metcalf/hvac_control/zone_controller/README.md

lvgl_esp32_drivers is old and doesn't support ESP32S3, forks that look promising:

- https://github.com/VitorAlho/lvgl_esp32_drivers
- https://github.com/artemisoftnian/lvgl_esp32_drivers
- https://github.com/BunnySakura/lvgl_esp32_drivers
- https://github.com/COP-AMACO/lvgl_esp32_drivers
