metcalf/hvac_control/components/cxi_client/README.md

Ported from Go: https://github.com/gonzojive/heatpump/tree/main/fancoil
