metcalf/hvac_control/case/label_alignment.dxf

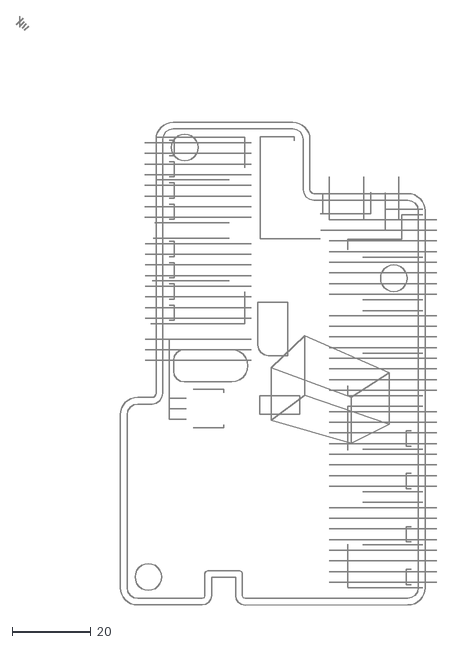
[picture p2: CAD file, 2024-07-10]
case/label_alignment.dxf
106.7 x 149.5
