metcalf/hvac_control/case/touch_panel_bracket.dxf

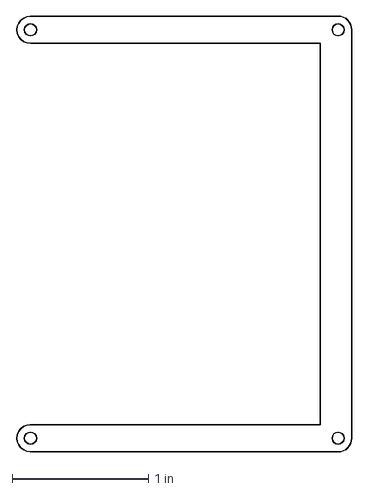
[picture p3: CAD file, 2024-07-08]
case/touch_panel_bracket.dxf
2.46 x 3.20 in
