metcalf/hvac_control/case/controller_top.stl

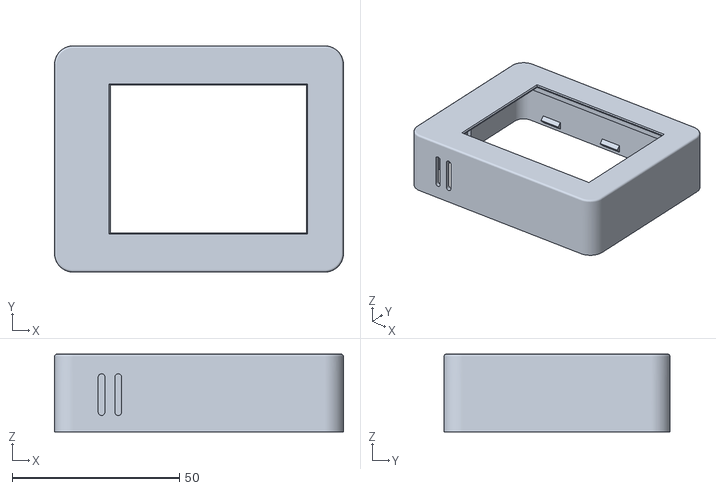
[picture p4: CAD file, 2024-06-24]
case/controller_top.stl
86.5 x 67.7 x 23.3
