metcalf/hvac_control/case/controller_bottom_v3.stl

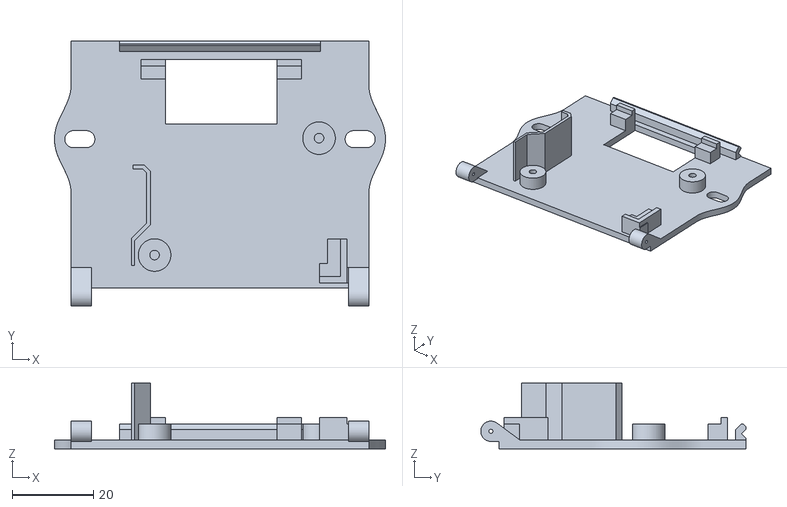
[picture p5: CAD file, 2024-06-24]
case/controller_bottom_v3.stl
81.3 x 65.2 x 16.1
