metcalf/hvac_control/case/label plate.dxf

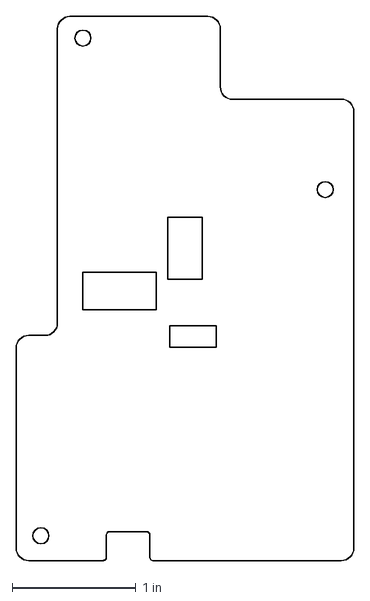
[picture p6: CAD file, 2024-06-24]
case/label plate.dxf
2.73 x 4.40 in
