metcalf/hvac_control/case/20240705-label-plate.dxf

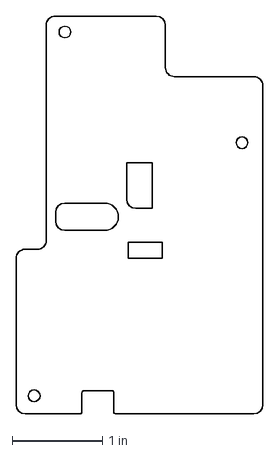
[picture p7: CAD file, 2024-07-08]
case/20240705-label-plate.dxf
2.73 x 4.40 in
