metcalf/hvac_control/(list of files, cad)

Other CAD files:
case/controller_top_v3.stl
case/controller_bottom.stl
case/controller_bottom_v2.stl
case/controller_top_v2.stl
