metcalf/hvac_control/eagle/printed/20251027-temp_board.brd

## EAGLE design eagle/printed/20251027-temp_board.brd (2025-10-27)

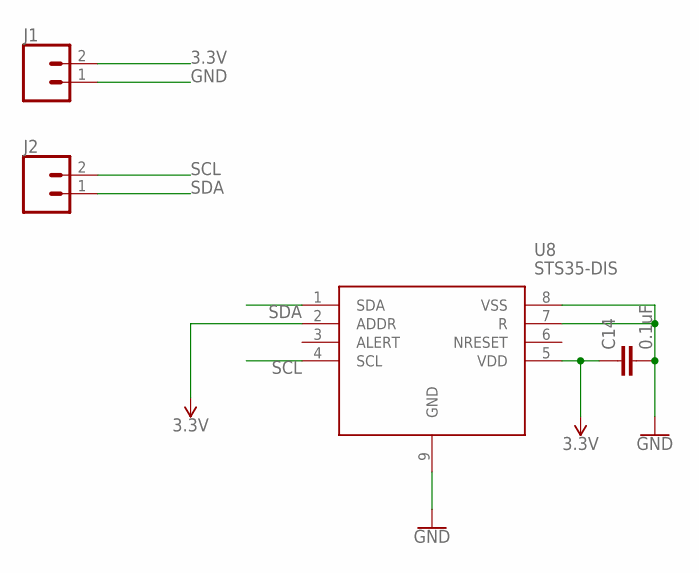
[picture p8: schematic 20251027-temp_board.sch]

Parts:
C14: 0.1uF; 0603
J1, J2: CONN_02_1.5MM; 1X02_1.5MM_NO_SILK
U8: STS35-DIS; SON50P250X250X100-9N

Connections:
3.3V: C14.1, J1.2, U8.2 (ADDR), U8.5 (VDD)
GND: C14.2, J1.1, U8.7 (R), U8.8 (VSS), U8.9 (GND)
SCL: J2.2, U8.4 (SCL)
SDA: J2.1, U8.1 (SDA)

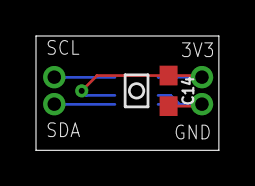
[picture p9: board 20251027-temp_board.brd from above]

Board: 2 copper layers, 10.2 x 6.3 mm, 4 parts (1 on the bottom side), 4 nets.
