metcalf/hvac_control/eagle/rs485/fresh_air_control.brd

## EAGLE design eagle/rs485/fresh_air_control.brd (2025-07-13)

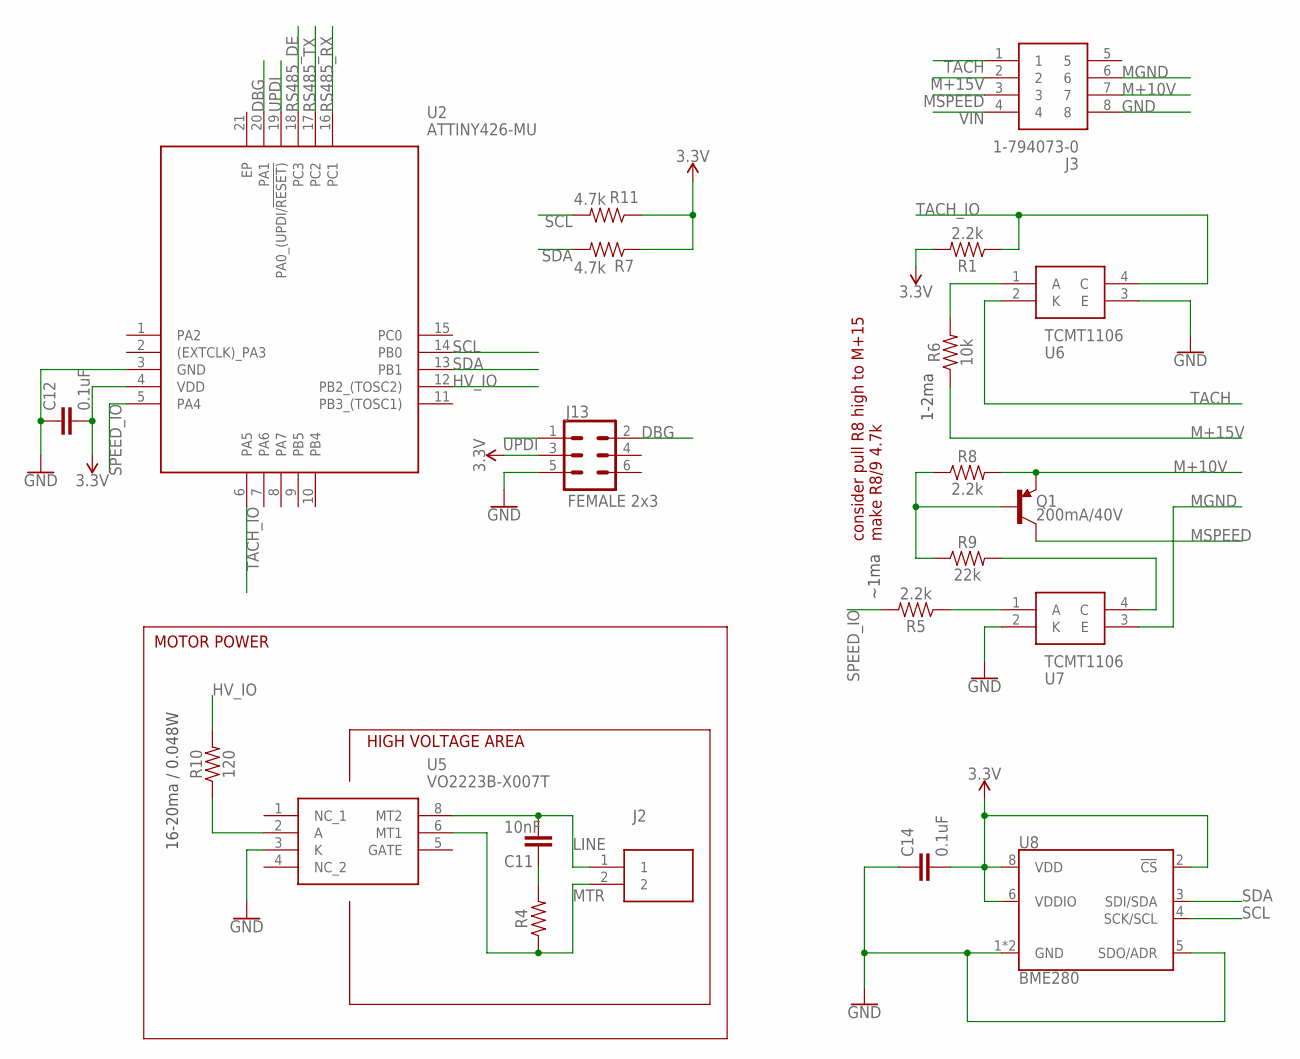
[picture p10: schematic fresh_air_control.sch, sheet 1]

Parts:
C11: 10nF; 0805
C12, C14: 0.1uF; 0603
J2: 1-770166-0; 17701660
J3: 1-794073-0; 17940730
J13: FEMALE 2x3; 2X3
Q1: 200mA/40V; SOT23-3
R1, R5, R8: 2.2k; 0603
R4: 100; 0805
R6: 10k; 0603
R7, R11: 4.7k; 0603
R9: 22k; 0603
R10: 120; 0603
U2: ATTINY426-MU; QFN40P300X300X90-21N
U5: VO2223B-X007T; VO2223BX007T
U6, U7: TCMT1106; SOIC127P700X230-4N
U8: BME280; LGA-8-2.5X2.5

Connections:
3.3V: C12.2, C14.2, J13.3, R1.2, R7.1, R11.1, U2.4 (VDD), U8.2 (!CS), U8.6 (VDDIO), U8.8 (VDD); also elsewhere on the board
DBG: J13.2, U2.20 (PA1)
GND: C12.1, C14.1, J3.8, J13.5, U2.3 (GND), U5.3 (K), U6.3 (E), U7.2 (K), U8.1 (GND), U8.5 (SDO/ADR), U8.7 (GND); also elsewhere on the board
HV_IO: R10.2, U2.12 (PB2_(TOSC2)); also elsewhere on the board
HV_SW: R10.1, U5.2 (A)
LINE: C11.1, J2.1, U5.8 (MT2)
M+10V: J3.7, Q1.2 (E), R8.2
M+15V: J3.2, R6.1
MGND: J3.6, U7.3 (E)
MSPEED: J3.3, Q1.3 (C)
MTR: J2.2, R4.1, U5.6 (MT1)
unnamed: R6.2, U6.1 (A)
unnamed: C11.2, R4.2
unnamed: R5.1, U7.1 (A)
unnamed: Q1.1 (B), R8.1, R9.1
unnamed: R9.2, U7.4 (C)
RS485_DE: U2.18 (PC3); also elsewhere on the board
RS485_RX: U2.16 (PC1); also elsewhere on the board
RS485_TX: U2.17 (PC2); also elsewhere on the board
SCL: R11.2, U2.14 (PB0), U8.4 (SCK/SCL); also elsewhere on the board
SDA: R7.2, U2.13 (PB1), U8.3 (SDI/SDA); also elsewhere on the board
SPEED_IO: R5.2, U2.5 (PA4); also elsewhere on the board
TACH: J3.1, U6.2 (K)
TACH_IO: R1.1, U2.6 (PA5), U6.4 (C); also elsewhere on the board
UPDI: J13.1, U2.19 (PA0_(UPDI/!RESET))
VIN: J3.4; also elsewhere on the board

Notes on the sheet:
HIGH VOLTAGE AREA
16-20ma / 0.048W
~1ma
1-2ma
MOTOR POWER
consider pull R8 high to M+15 make R8/9 4.7k

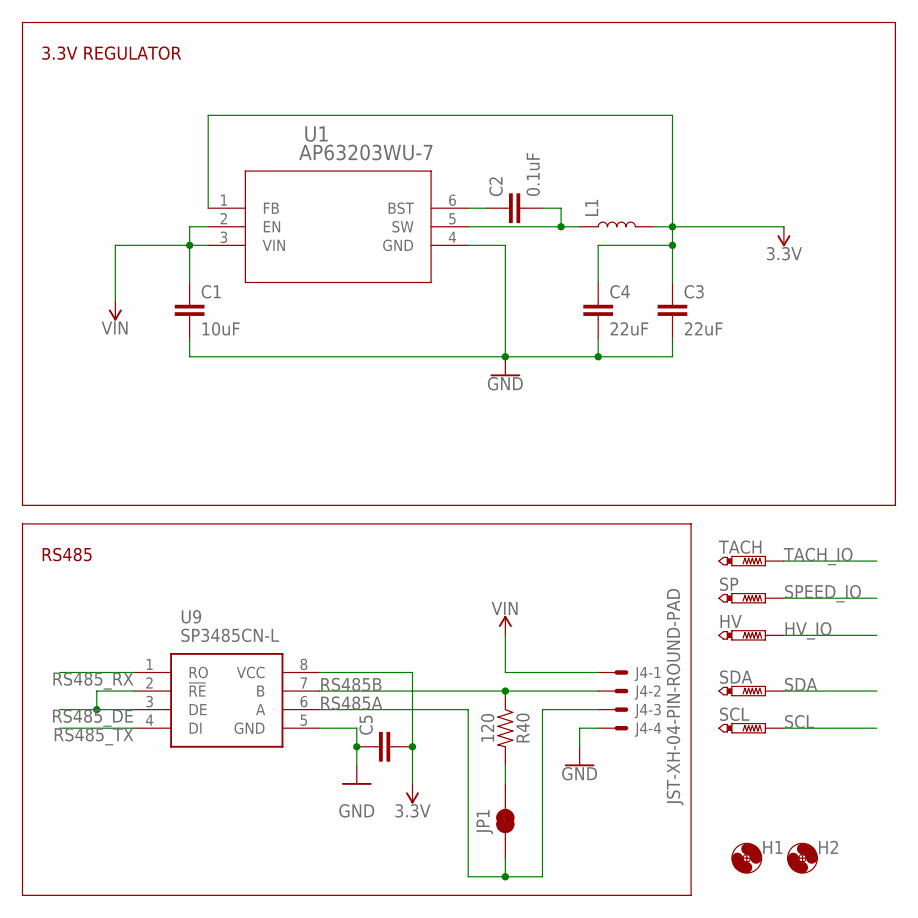
[picture p11: schematic fresh_air_control.sch, sheet 2]

Parts:
C1: 10uF; 1206
C2, C5: 0.1uF; 0603
C3, C4: 22uF; 0805
H1, H2: MOUNT-HOLE3.3; 3,3
HV: PTR1B1,27; B1,27
J4: JST-XH-04-PIN-ROUND-PAD; JST-XH-04-PACKAGE-ROUND-PAD
JP1: JUMPER-SMT_2_NC_TRACE_NO-SILK; SMT-JUMPER_2_NC_TRACE_NO-SILK
L1: 4.7μH_SHIELDED_INDUCTOR; 1008(2520)
R40: 120; 0603
SCL: PTR1B1,27; B1,27
SDA: PTR1B1,27; B1,27
SP: PTR1B1,27; B1,27
TACH: PTR1B1,27; B1,27
U1: AP63203WU-7; SOIC_05WU-7_DIO
U9: SP3485CN-L; SOIC127P600X175-8N

Connections:
3.3V: C3.1, C4.1, C5.2, L1.2, U1.1 (FB), U9.8 (VCC); also elsewhere on the board
GND: C1.2, C3.2, C4.2, C5.1, J4.4, U1.4 (GND), U9.5 (GND); also elsewhere on the board
HV_IO: HV.TP; also elsewhere on the board
unnamed: C2.2, L1.1, U1.5 (SW)
unnamed: C2.1, U1.6 (BST)
unnamed: JP1.2, R40.2
RS485A: J4.3, JP1.1, U9.6 (A)
RS485B: J4.2, R40.1, U9.7 (B)
RS485_DE: U9.2 (!RE), U9.3 (DE); also elsewhere on the board
RS485_RX: U9.1 (RO); also elsewhere on the board
RS485_TX: U9.4 (DI); also elsewhere on the board
SCL: SCL.TP; also elsewhere on the board
SDA: SDA.TP; also elsewhere on the board
SPEED_IO: SP.TP; also elsewhere on the board
TACH_IO: TACH.TP; also elsewhere on the board
VIN: C1.1, J4.1, U1.2 (EN), U1.3 (VIN); also elsewhere on the board

Notes on the sheet:
3.3V REGULATOR
RS485

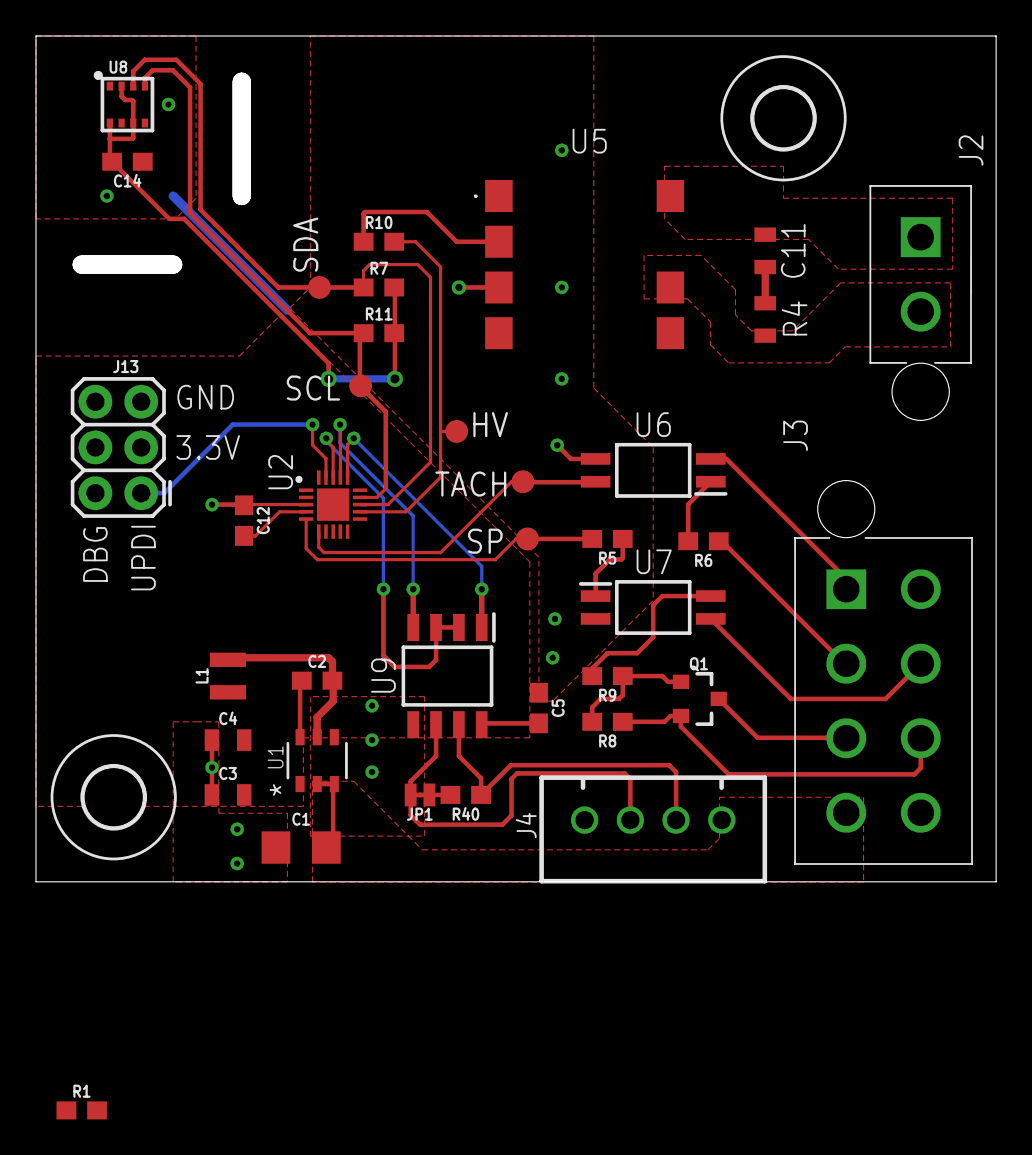
[picture p12: board fresh_air_control.brd from above]

Board: 2 copper layers, 53.3 x 47.0 mm, 39 parts (0 on the bottom side), 31 nets.
