metcalf/hvac_control/eagle/rs485/fancoil.brd

## EAGLE design eagle/rs485/fancoil.brd (2025-07-13)

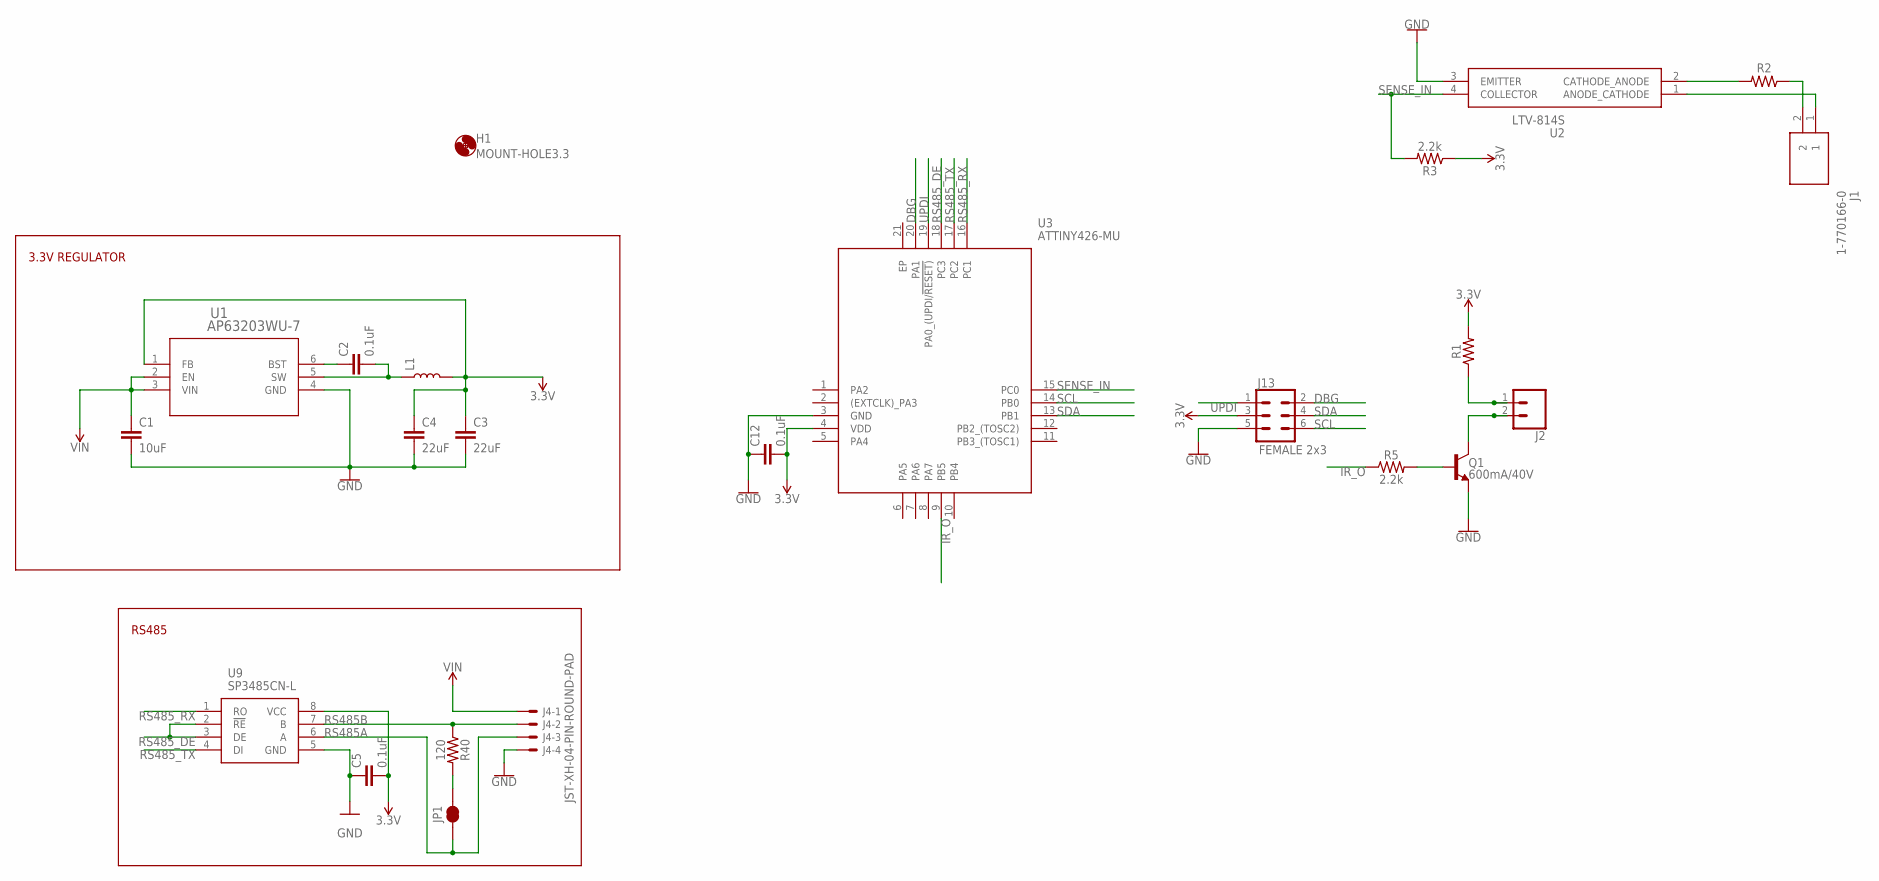
[picture p13: schematic fancoil.sch]

Parts:
C1: 10uF; 1206
C2, C5, C12: 0.1uF; 0603
C3, C4: 22uF; 0805
H1: MOUNT-HOLE3.3; 3,3
J1: 1-770166-0; 17701660
J2: CONN_02; 1X02
J4: JST-XH-04-PIN-ROUND-PAD; JST-XH-04-PACKAGE-ROUND-PAD
J13: FEMALE 2x3; 2X3
JP1: JUMPER-SMT_2_NC_TRACE_NO-SILK; SMT-JUMPER_2_NC_TRACE_NO-SILK
L1: 4.7μH_SHIELDED_INDUCTOR; 1008(2520)
Q1: 600mA/40V; SOT23-3
R1: 68OHM-0603-1/10W-1%; 0603
R2: AXIAL-0.3
R3, R5: 2.2k; 0603
R40: 120; 0603
U1: AP63203WU-7; SOIC_05WU-7_DIO
U2: LTV-814S; SOP254P1016X460-4N
U3: ATTINY426-MU; QFN40P300X300X90-21N
U9: SP3485CN-L; SOIC127P600X175-8N

Connections:
3.3V: C3.1, C4.1, C5.2, C12.2, J13.3, L1.2, R1.2, R3.1, U1.1 (FB), U3.4 (VDD), U9.8 (VCC)
DBG: J13.2, U3.20 (PA1)
GND: C1.2, C3.2, C4.2, C5.1, C12.1, J4.4, J13.5, Q1.2 (E), U1.4 (GND), U2.3 (EMITTER), U3.3 (GND), U9.5 (GND)
IR_O: R5.1, U3.9 (PB5)
unnamed: C2.2, L1.1, U1.5 (SW)
unnamed: C2.1, U1.6 (BST)
unnamed: JP1.2, R40.2
unnamed: J2.1, R1.1
unnamed: Q1.1 (B), R5.2
unnamed: J1.2, R2.P$1 (1)
unnamed: J1.1, U2.1 (ANODE_CATHODE)
unnamed: R2.P$2 (2), U2.2 (CATHODE_ANODE)
unnamed: J2.2, Q1.3 (C)
RS485A: J4.3, JP1.1, U9.6 (A)
RS485B: J4.2, R40.1, U9.7 (B)
RS485_DE: U3.18 (PC3), U9.2 (!RE), U9.3 (DE)
RS485_RX: U3.16 (PC1), U9.1 (RO)
RS485_TX: U3.17 (PC2), U9.4 (DI)
SCL: J13.6, U3.14 (PB0)
SDA: J13.4, U3.13 (PB1)
SENSE_IN: R3.2, U2.4 (COLLECTOR), U3.15 (PC0)
UPDI: J13.1, U3.19 (PA0_(UPDI/!RESET))
VIN: C1.1, J4.1, U1.2 (EN), U1.3 (VIN)

Notes on the sheet:
3.3V REGULATOR
RS485

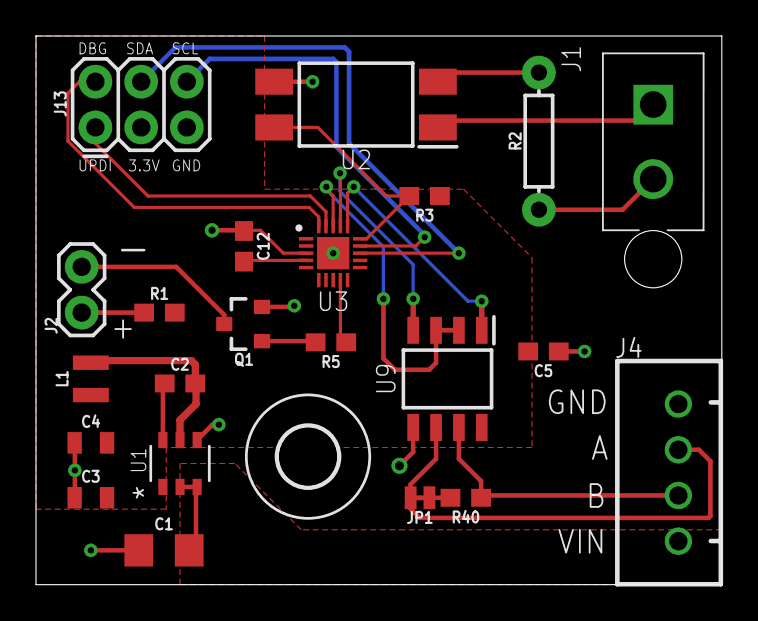
[picture p14: board fancoil.brd from above]

Board: 2 copper layers, 38.1 x 30.5 mm, 23 parts (0 on the bottom side), 23 nets.
