metcalf/hvac_control/eagle/rs485/controller.brd

## EAGLE design eagle/rs485/controller.brd (2025-07-13)

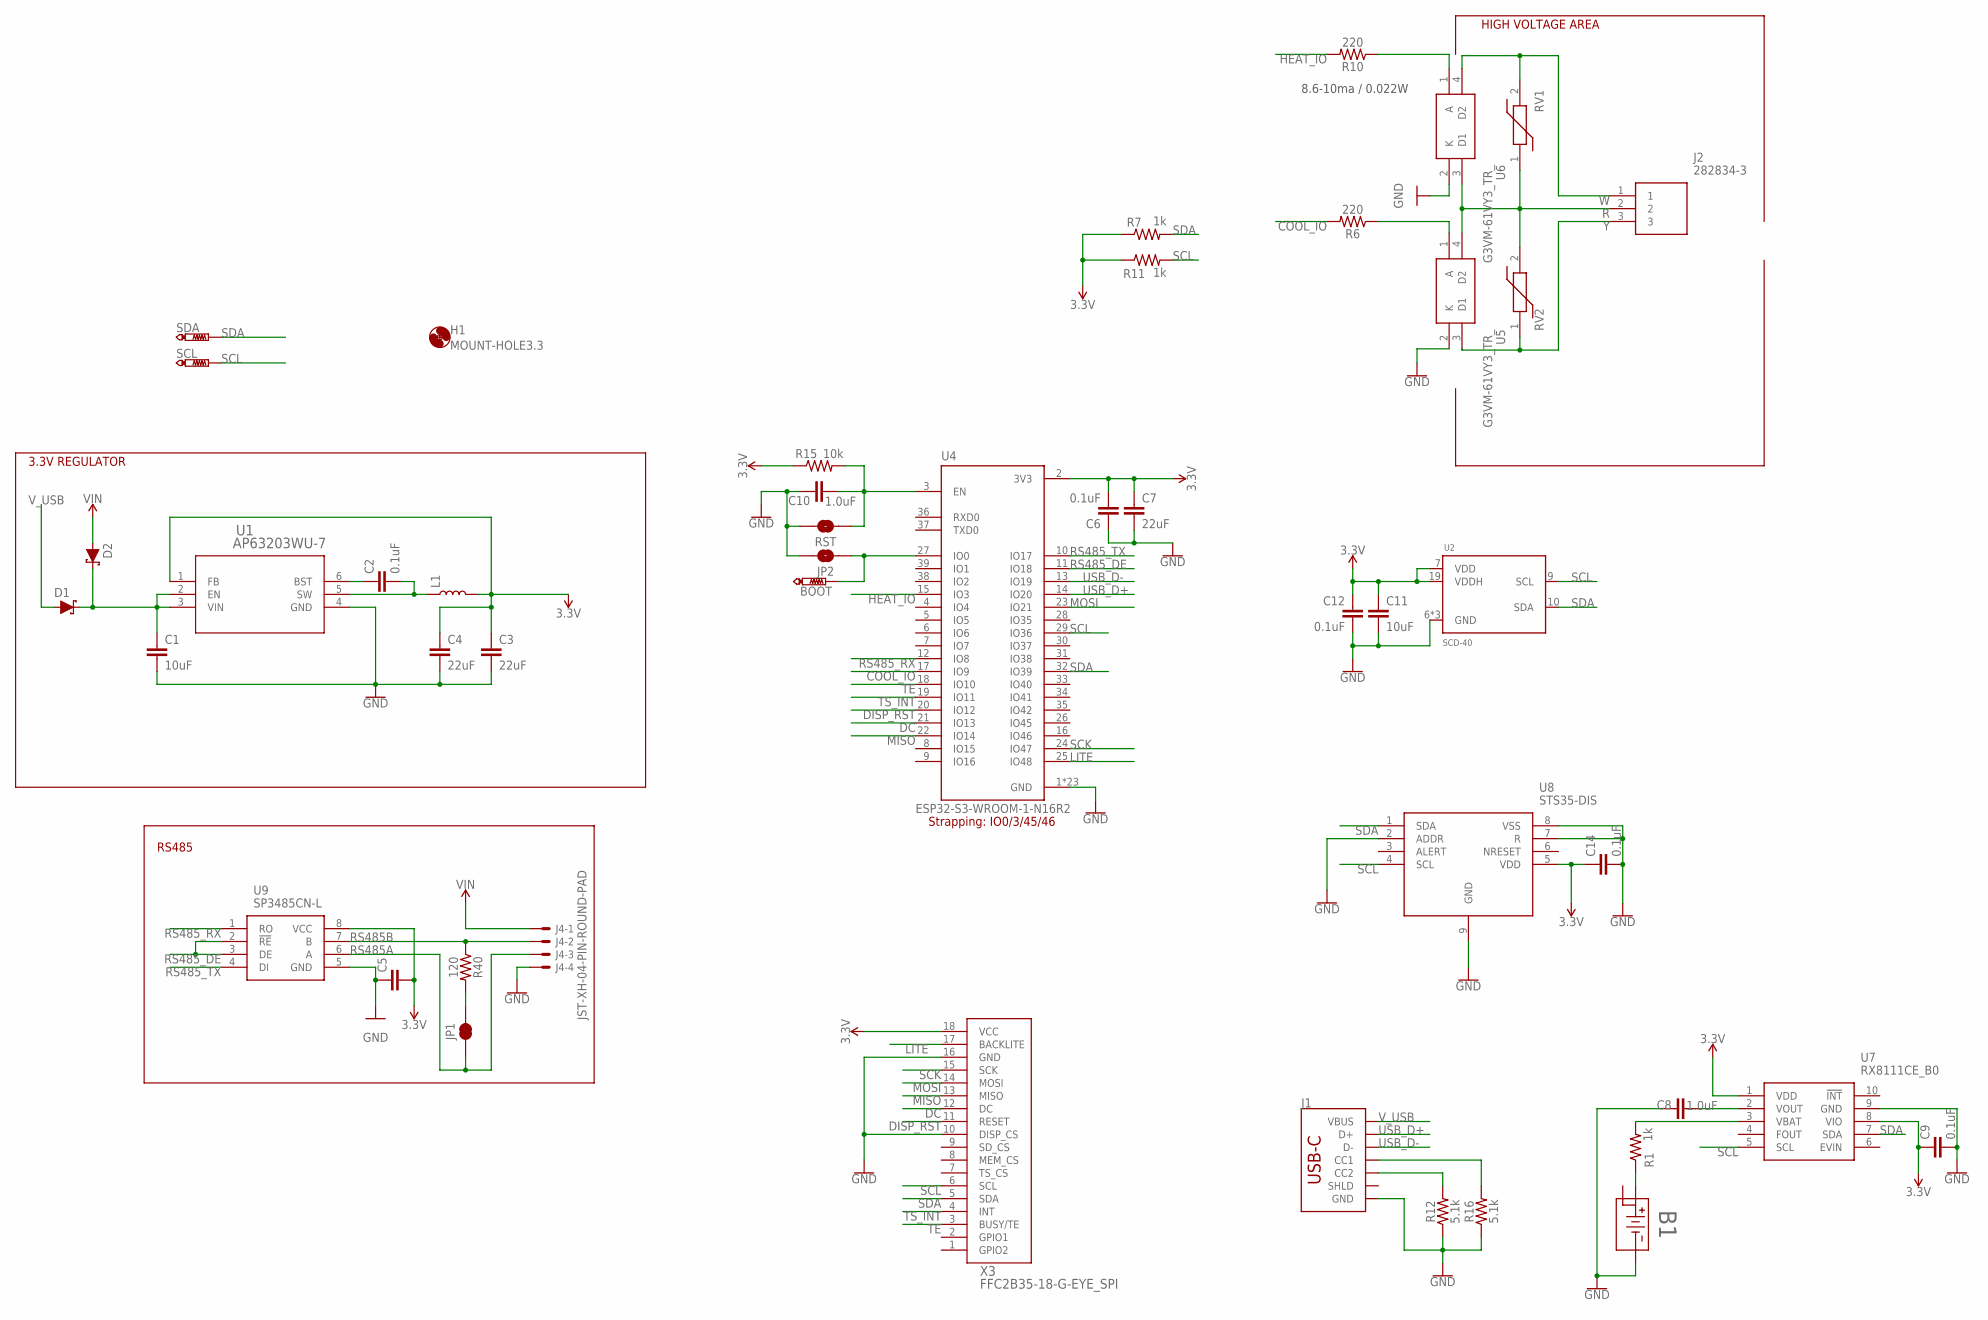
[picture p15: schematic controller.sch]

Parts:
B1: BAT-HLD-012-SMT; BAT-HLD-012-SMT_TEC
BOOT: PTR1B1,27; B1,27
C1, C11: 10uF; 1206
C2, C5, C6, C9, C12, C14: 0.1uF; 0603
C3, C4, C7: 22uF; 0805
C8, C10: 1.0uF; 0603
D1, D2: 1A/23V/620mV; SOD-323
H1: MOUNT-HOLE3.3; 3,3
J1: USB_C_2-LAYER_PADS; USB-C-16P-2LAYER-PADS
J2: 282834-3; 2828343
J4: JST-XH-04-PIN-ROUND-PAD; JST-XH-04-PACKAGE-ROUND-PAD
JP1: JUMPER-SMT_2_NC_TRACE_NO-SILK; SMT-JUMPER_2_NC_TRACE_NO-SILK
JP2: JUMPER-SMT_2_NO_NO-SILK; SMT-JUMPER_2_NO_NO-SILK
L1: 4.7μH_SHIELDED_INDUCTOR; 1008(2520)
R1, R7, R11: 1k; 0603
R6, R10: 220; 0603
R12, R16: 5.1k; 0603
R15: 10k; 0603
R40: 120; 0603
RST: JUMPER-SMT_2_NO_NO-SILK; SMT-JUMPER_2_NO_NO-SILK
RV1, RV2: ZV35K1210251NIR1; VARC3225X145N
SCL: PTR1B1,27; B1,27
SDA: PTR1B1,27; B1,27
U1: AP63203WU-7; SOIC_05WU-7_DIO
U2: SCD-40; SCD40
U4: ESP32-S3-WROOM-1-N16R2; XCVR_ESP32-S3-WROOM-1-N16R2
U5, U6: G3VM-61VY3_TR_; G3VM61VY3TR
U7: RX8111CE_B0; RX8111CEB0
U8: STS35-DIS; SON50P250X250X100-9N
U9: SP3485CN-L; SOIC127P600X175-8N
X3: FFC2B35-18-G-EYE_SPI; FFC2B3518G

Connections:
3.3V: C3.1, C4.1, C5.2, C6.2, C7.1, C9.1, C11.1, C12.2, C14.1, L1.2, R7.1, R11.1, R15.1, U1.1 (FB), U2.7 (VDD), U2.19 (VDDH), U4.2 (3V3), U7.1 (VDD), U7.8 (VIO), U8.5 (VDD), U9.8 (VCC), X3.18 (VCC)
COOL_IO: R6.2, U4.17 (IO9)
DC: U4.21 (IO13), X3.12 (DC)
DISP_RST: U4.20 (IO12), X3.11 (RESET)
GND: B1.3, C1.2, C3.2, C4.2, C5.1, C6.1, C7.2, C8.1, C9.2, C10.1, C11.2, C12.1, C14.2, J1.GND, J1.GND2 (GND), J4.4, JP2.2, R12.1, R16.1, RST.2, U1.4 (GND), U2.6 (GND), U2.20 (GND), U2.P$1 (GND), U4.1 (GND), U4.40 (GND), U4.41_1 (GND), U4.41_2 (GND), U4.41_3 (GND), U4.41_4 (GND), U4.41_5 (GND), U4.41_6 (GND), U4.41_7 (GND), U4.41_8 (GND), U4.41_9 (GND), U4.41_10 (GND), U4.41_11 (GND), U4.41_12 (GND), U4.41_13 (GND), U4.41_14 (GND), U4.41_15 (GND), U4.41_16 (GND), U4.41_17 (GND), U4.41_18 (GND), U4.41_19 (GND), U4.41_20 (GND), U4.41_21 (GND), U5.2 (K), U6.2 (K), U7.9 (GND), U8.2 (ADDR), U8.7 (R), U8.8 (VSS), U8.9 (GND), U9.5 (GND), X3.10 (DISP_CS), X3.16 (GND)
HEAT_IO: R10.2, U4.15 (IO3)
LITE: U4.25 (IO48), X3.17 (BACKLITE)
MISO: U4.22 (IO14), X3.13 (MISO)
MOSI: U4.23 (IO21), X3.14 (MOSI)
unnamed: C2.2, L1.1, U1.5 (SW)
unnamed: C2.1, U1.6 (BST)
unnamed: BOOT.TP, JP2.1, U4.27 (IO0)
unnamed: R6.1, U5.1 (A)
unnamed: JP1.2, R40.2
unnamed: B1.1, R1.1
unnamed: J1.A5 (CC1), R16.2
unnamed: C10.2, R15.2, RST.1, U4.3 (EN)
unnamed: R10.1, U6.1 (A)
unnamed: J1.B5 (CC2), R12.2
R: J2.2, RV1.1, RV2.2, U5.4 (D2), U6.3 (D1)
REG_IN: C1.1, D1.C, D2.C, U1.2 (EN), U1.3 (VIN)
RS485A: J4.3, JP1.1, U9.6 (A)
RS485B: J4.2, R40.1, U9.7 (B)
RS485_DE: U4.11 (IO18), U9.2 (!RE), U9.3 (DE)
RS485_RX: U4.12 (IO8), U9.1 (RO)
RS485_TX: U4.10 (IO17), U9.4 (DI)
RTC_VBAT: R1.2, U7.3 (VBAT)
RTC_VOUT: C8.2, U7.2 (VOUT)
SCK: U4.24 (IO47), X3.15 (SCK)
SCL: R11.2, SCL.TP, U2.9 (SCL), U4.29 (IO36), U7.5 (SCL), U8.4 (SCL), X3.6 (SCL)
SDA: R7.2, SDA.TP, U2.10 (SDA), U4.32 (IO39), U7.7 (SDA), U8.1 (SDA), X3.5 (SDA)
TE: U4.18 (IO10), X3.3 (BUSY/TE)
TS_INT: U4.19 (IO11), X3.4 (INT)
USB_D+: J1.A6 (D+), J1.B6 (D+), U4.14 (IO20)
USB_D-: J1.A7 (D-), J1.B7 (D-), U4.13 (IO19)
VIN: D2.A, J4.1
V_USB: D1.A, J1.VBUS1 (VBUS), J1.VBUS2 (VBUS)
W: J2.1, RV1.2, U6.4 (D2)
Y: J2.3, RV2.1, U5.3 (D1)

Notes on the sheet:
Strapping: IO0/3/45/46
HIGH VOLTAGE AREA
8.6-10ma / 0.022W
3.3V REGULATOR
RS485

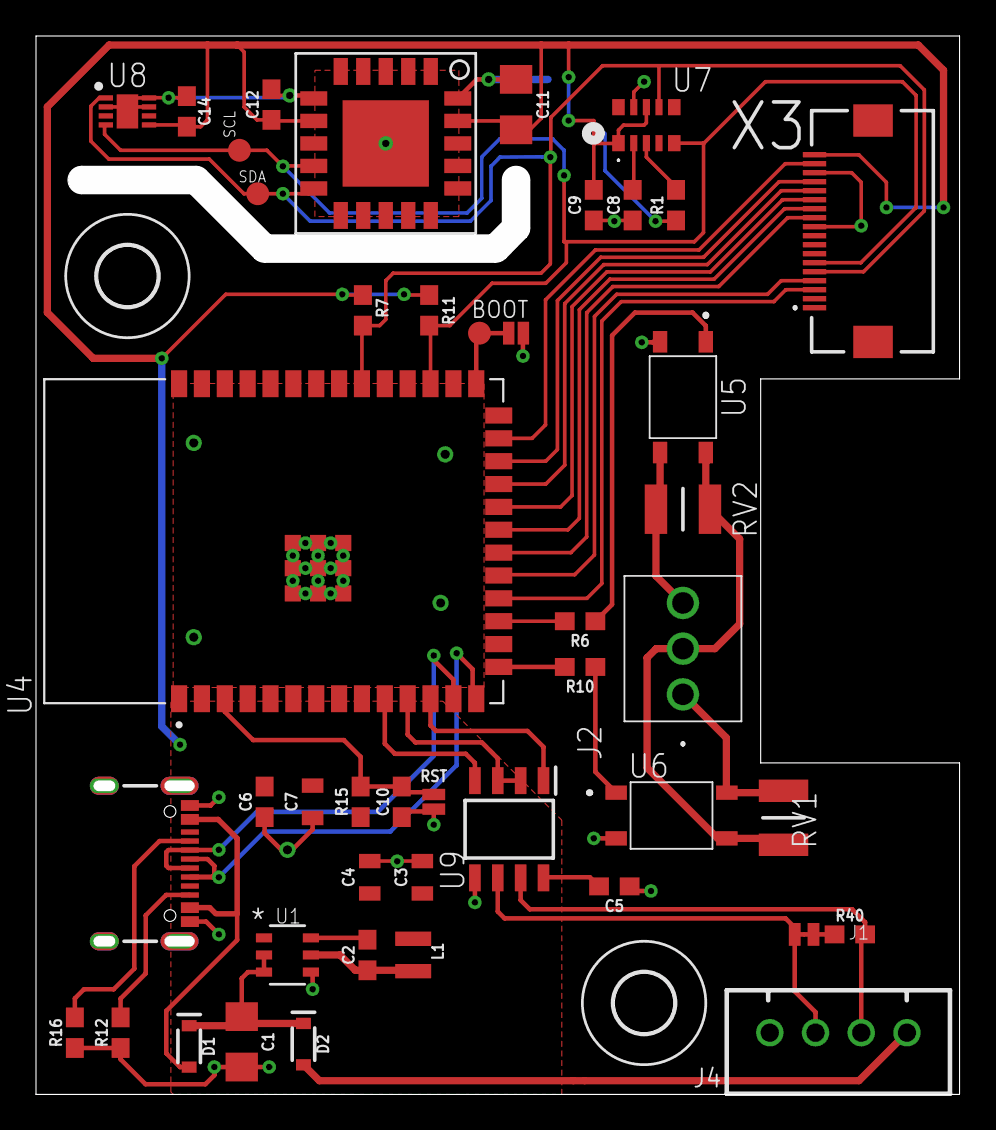
[picture p16: board controller.brd from above]

Board: 2 copper layers, 51.3 x 58.8 mm, 48 parts (1 on the bottom side), 39 nets.

Other parts of the board:
H2: MOUNT-HOLE3.3; 3,3
