metcalf/hvac_control/eagle/rs485/zone_ctrl.brd

## EAGLE design eagle/rs485/zone_ctrl.brd (2025-07-12)

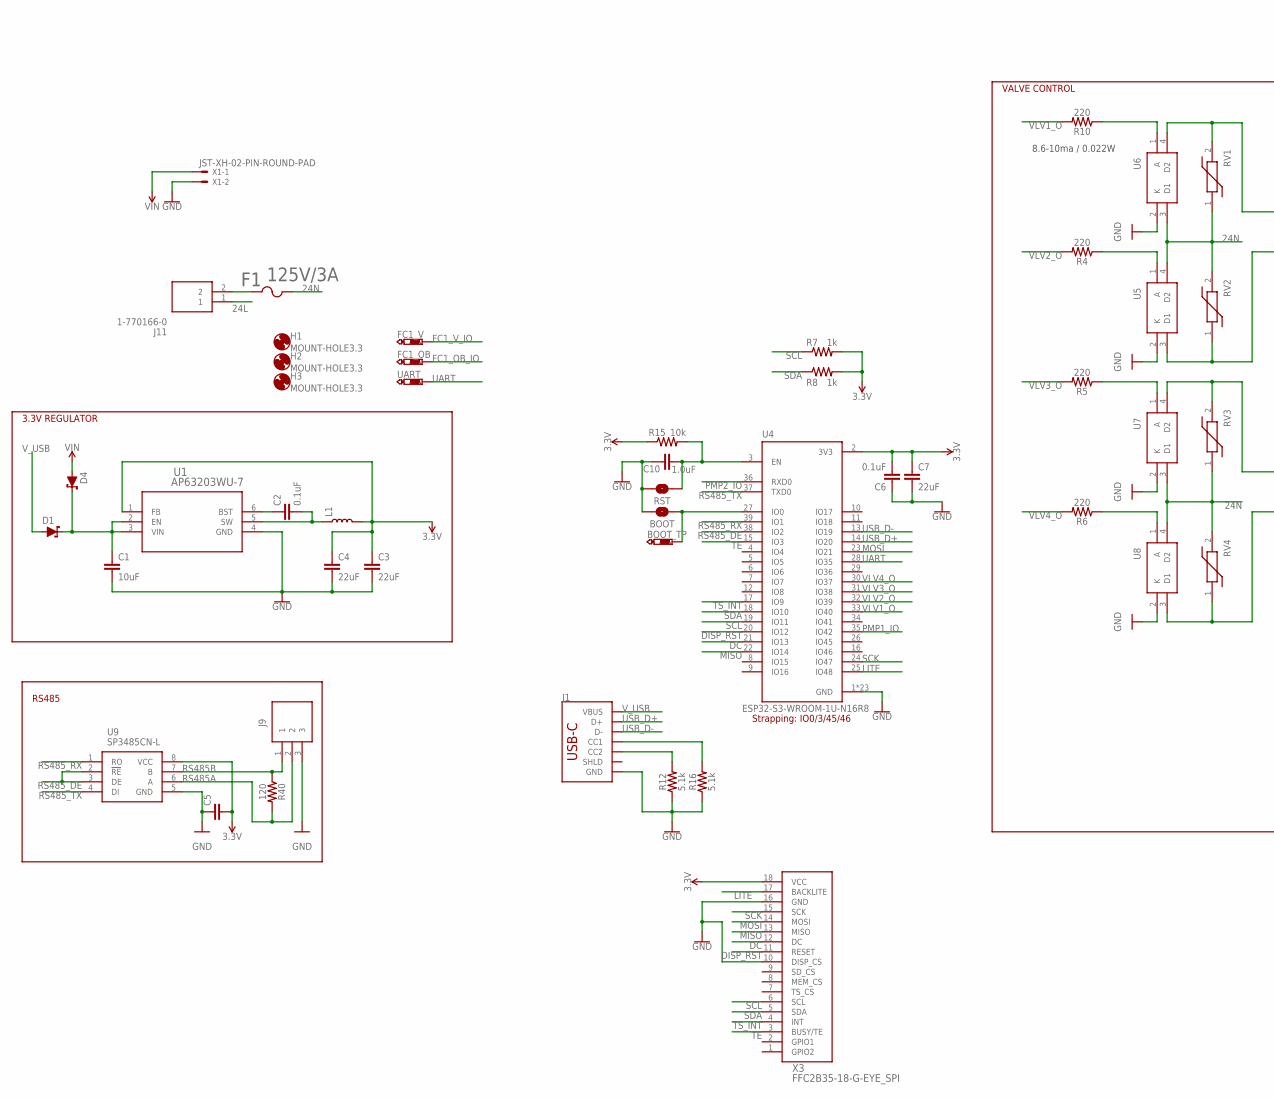
[picture p17: schematic zone_ctrl.sch, part in row 1, column 1]

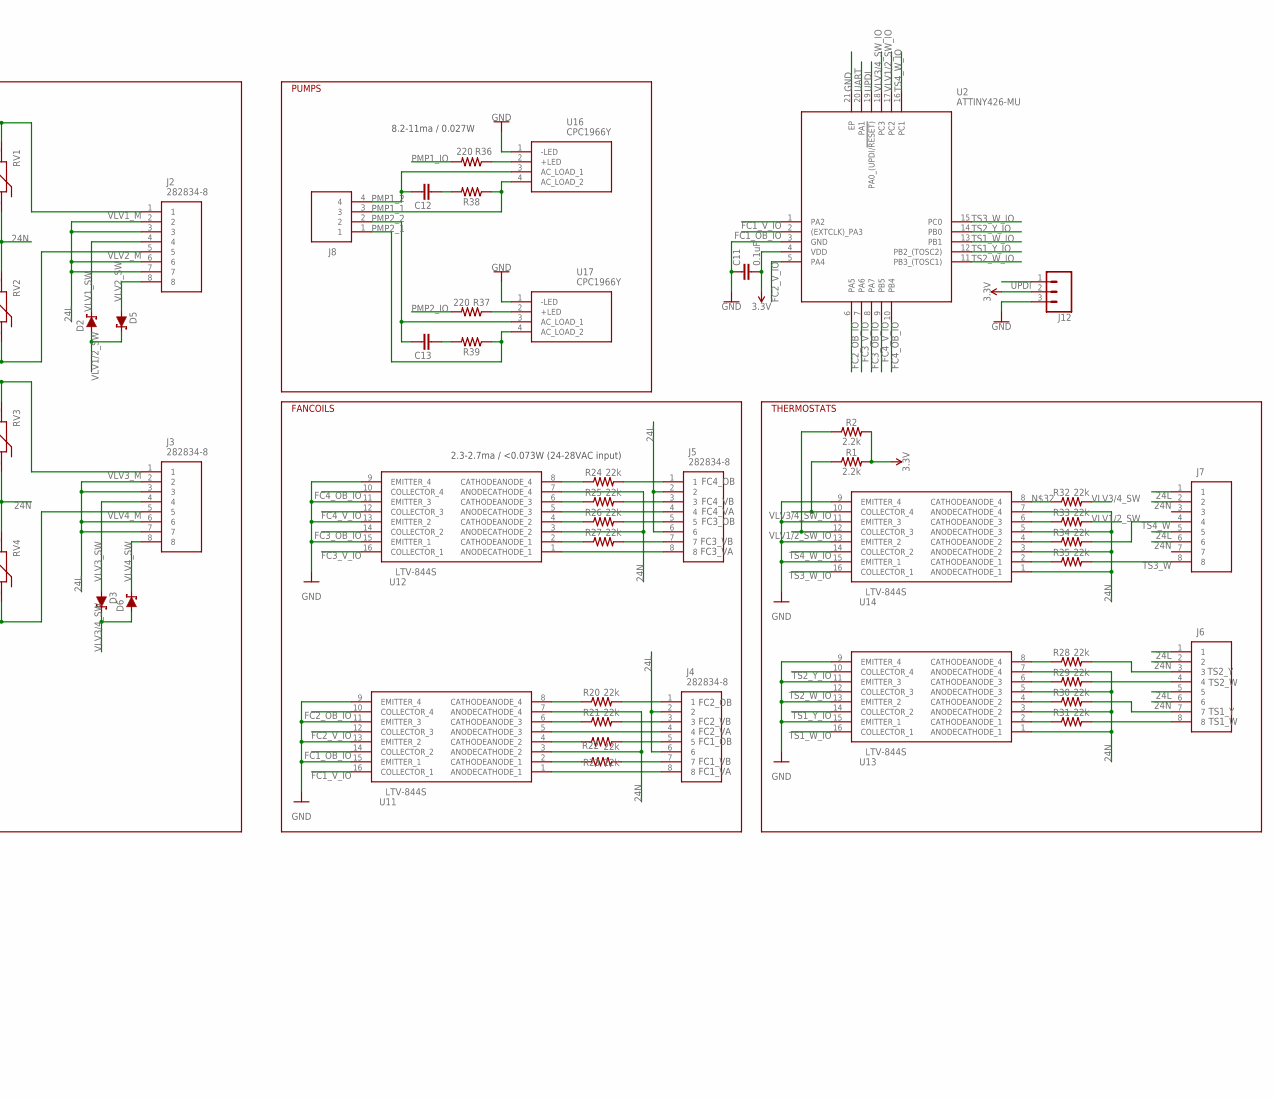
[picture p18: schematic zone_ctrl.sch, part in row 1, column 2]

Parts:
BOOT: JUMPER-SMT_2_NO_NO-SILK; SMT-JUMPER_2_NO_NO-SILK
BOOT_TP: PTR1B1,27; B1,27
C1: 10uF; 1206
C2, C5, C6, C11: 0.1uF; 0603
C3, C4, C7: 22uF; 0805
C10: 1.0uF; 0603
C12, C13: 10nF; 0805
D1, D2, D3, D4, D5, D6: 1A/23V/620mV; SOD-323
F1: 125V/3A; 01550900M
FC1_OB, FC1_V: PTR1B1,27; B1,27
H1, H2, H3: MOUNT-HOLE3.3; 3,3
J1: USB_C_2-LAYER_PADS; USB-C-16P-2LAYER-PADS
J2, J3, J4, J5, J6, J7: 282834-8; 2828348
J8: 4DB-P108-04; SHDR4W132P0X826_1X4_3467X1270X
J9: 282834-3; 2828343
J11: 1-770166-0; 17701660
J12: 455-1750-1-ND; 1X03
L1: 4.7μH_SHIELDED_INDUCTOR; 1008(2520)
R1, R2: 2.2k; 0603
R4, R5, R6, R10, R36, R37: 220; 0603
R7, R8: 1k; 0603
R12, R16: 5.1k; 0603
R15: 10k; 0603
R20, R21, R22, R23, R24, R25, R26, R27, R28, R29, R30, R31, R32, R33, R34, R35: 22k; 0603
R38, R39: 100; 0805
R40: 120; 0603
RST: JUMPER-SMT_2_NO_NO-SILK; SMT-JUMPER_2_NO_NO-SILK
RV1, RV2, RV3, RV4: ZV35K1210251NIR1; VARC3225X145N
U1: AP63203WU-7; SOIC_05WU-7_DIO
U2: ATTINY426-MU; QFN40P300X300X90-21N
U4: ESP32-S3-WROOM-1U-N16R8; ESP32S3WROOM1UN16R8
U5, U6, U7, U8: G3VM-61VY3_TR_; G3VM61VY3TR
U9: SP3485CN-L; SOIC127P600X175-8N
U11, U12, U13, U14: LTV-844S; LTV846S
U16, U17: CPC1966Y
UART: PTR1B1,27; B1,27
X1: JST-XH-02-PIN-ROUND-PAD; JST-XH-02-PACKAGE-ROUND-PAD
X3: FFC2B35-18-G-EYE_SPI; FFC2B3518G

Connections:
3.3V: C3.1, C4.1, C5.2, C6.2, C7.1, C11.2, J12.2, L1.2, R1.2, R2.2, R7.2, R8.2, R15.1, U1.1 (FB), U2.4 (VDD), U4.2 (3V3), U9.8 (VCC), X3.18 (VCC)
24L: J2.2, J2.3, J2.6, J2.7, J3.2, J3.3, J3.6, J3.7, J4.2, J4.6, J5.2, J5.6, J6.1, J6.5, J7.1, J7.5, J11.1
24N: F1.2, J6.2, J6.6, J7.2, J7.6, RV1.1, RV2.2, RV3.1, RV4.2, U5.4 (D2), U6.3 (D1), U7.3 (D1), U8.4 (D2), U11.3 (ANODECATHODE_2), U11.7 (ANODECATHODE_4), U12.3 (ANODECATHODE_2), U12.7 (ANODECATHODE_4), U13.1 (ANODECATHODE_1), U13.3 (ANODECATHODE_2), U13.5 (ANODECATHODE_3), U13.7 (ANODECATHODE_4), U14.1 (ANODECATHODE_1), U14.3 (ANODECATHODE_2), U14.5 (ANODECATHODE_3), U14.7 (ANODECATHODE_4)
DC: U4.21 (IO13), X3.12 (DC)
DISP_RST: U4.20 (IO12), X3.11 (RESET)
FC1_OB: J4.5, R22.2
FC1_OB_IO: FC1_OB.TP, U2.2 ((EXTCLK)_PA3), U11.14 (COLLECTOR_2)
FC1_VA: J4.8, U11.1 (ANODECATHODE_1)
FC1_VB: J4.7, R23.2
FC1_V_IO: FC1_V.TP, U2.1 (PA2), U11.16 (COLLECTOR_1)
FC2_OB: J4.1, R20.2
FC2_OB_IO: U2.6 (PA5), U11.10 (COLLECTOR_4)
FC2_VA: J4.4, U11.5 (ANODECATHODE_3)
FC2_VB: J4.3, R21.2
FC2_V_IO: U2.5 (PA4), U11.12 (COLLECTOR_3)
FC3_OB: J5.5, R26.2
FC3_OB_IO: U2.8 (PA7), U12.14 (COLLECTOR_2)
FC3_VA: J5.8, U12.1 (ANODECATHODE_1)
FC3_VB: J5.7, R27.2
FC3_V_IO: U2.7 (PA6), U12.16 (COLLECTOR_1)
FC4_OB: J5.1, R24.2
FC4_OB_IO: U2.10 (PB4), U12.10 (COLLECTOR_4)
FC4_VA: J5.4, U12.5 (ANODECATHODE_3)
FC4_VB: J5.3, R25.2
FC4_V_IO: U2.9 (PB5), U12.12 (COLLECTOR_3)
GND: BOOT.2, C1.2, C3.2, C4.2, C5.1, C6.1, C7.2, C10.1, C11.1, J1.GND, J1.GND2 (GND), J9.3, J12.3, R12.1, R16.1, RST.2, U1.4 (GND), U2.3 (GND), U2.21 (EP), U4.1 (GND), U4.40 (GND), U4.41 (GND), U4.41_10 (GND), U4.41_11 (GND), U4.41_12 (GND), U4.41_13 (GND), U4.41_14 (GND), U4.41_15 (GND), U4.41_16 (GND), U4.41_17 (GND), U4.41_18 (GND), U4.41_19 (GND), U4.41_20 (GND), U4.41_21 (GND), U4.42 (GND), U4.43 (GND), U4.44 (GND), U4.45 (GND), U4.46 (GND), U4.47 (GND), U4.48 (GND), U4.49 (GND), U5.2 (K), U6.2 (K), U7.2 (K), U8.2 (K), U9.5 (GND), U11.9 (EMITTER_4), U11.11 (EMITTER_3), U11.13 (EMITTER_2), U11.15 (EMITTER_1), U12.9 (EMITTER_4), U12.11 (EMITTER_3), U12.13 (EMITTER_2), U12.15 (EMITTER_1), U13.9 (EMITTER_4), U13.11 (EMITTER_3), U13.13 (EMITTER_2), U13.15 (EMITTER_1), U14.9 (EMITTER_4), U14.11 (EMITTER_3), U14.13 (EMITTER_2), U14.15 (EMITTER_1), U16.1 (-LED), U17.1 (-LED), X1.2, X3.10 (DISP_CS), X3.16 (GND)
LITE: U4.25 (IO48), X3.17 (BACKLITE)
MISO: U4.22 (IO14), X3.13 (MISO)
MOSI: U4.23 (IO21), X3.14 (MOSI)
unnamed: C2.2, L1.1, U1.5 (SW)
unnamed: C2.1, U1.6 (BST)
unnamed: BOOT.1, BOOT_TP.TP, U4.27 (IO0)
unnamed: R20.1, U11.8 (CATHODEANODE_4)
unnamed: J1.A5 (CC1), R16.2
unnamed: C10.2, R15.2, RST.1, U4.3 (EN)
unnamed: R10.1, U6.1 (A)
unnamed: R4.1, U5.1 (A)
unnamed: R22.1, U11.4 (CATHODEANODE_2)
unnamed: R5.1, U7.1 (A)
unnamed: J1.B5 (CC2), R12.2
unnamed: R21.1, U11.6 (CATHODEANODE_3)
unnamed: R6.1, U8.1 (A)
unnamed: R23.1, U11.2 (CATHODEANODE_1)
unnamed: R24.1, U12.8 (CATHODEANODE_4)
unnamed: R25.1, U12.6 (CATHODEANODE_3)
unnamed: R26.1, U12.4 (CATHODEANODE_2)
unnamed: R27.1, U12.2 (CATHODEANODE_1)
unnamed: R28.1, U13.8 (CATHODEANODE_4)
unnamed: R29.1, U13.6 (CATHODEANODE_3)
unnamed: R30.1, U13.4 (CATHODEANODE_2)
unnamed: R31.1, U13.2 (CATHODEANODE_1)
unnamed: R35.1, U14.2 (CATHODEANODE_1)
unnamed: R34.1, U14.4 (CATHODEANODE_2)
unnamed: F1.1, J11.2
unnamed: R33.1, U14.6 (CATHODEANODE_3)
unnamed: R32.1, U14.8 (CATHODEANODE_4)
unnamed: R37.1, U17.2 (+LED)
unnamed: R36.1, U16.2 (+LED)
unnamed: C12.2, R38.2
unnamed: C13.2, R39.2
PMP1_1: J8.3, R38.1, U16.4 (AC_LOAD_2)
PMP1_2: C12.1, J8.4, U16.3 (AC_LOAD_1)
PMP1_IO: R36.2, U4.35 (IO42)
PMP2_1: J8.1, R39.1, U17.4 (AC_LOAD_2)
PMP2_2: C13.1, J8.2, U17.3 (AC_LOAD_1)
PMP2_IO: R37.2, U4.36 (RXD0)
REG_IN: C1.1, D1.C, D4.C, U1.2 (EN), U1.3 (VIN)
RS485A: J9.2, R40.2, U9.6 (A)
RS485B: J9.1, R40.1, U9.7 (B)
RS485_DE: U4.38 (IO2), U9.2 (!RE), U9.3 (DE)
RS485_RX: U4.39 (IO1), U9.1 (RO)
RS485_TX: U4.37 (TXD0), U9.4 (DI)
SCK: U4.24 (IO47), X3.15 (SCK)
SCL: R7.1, U4.19 (IO11), X3.6 (SCL)
SDA: R8.1, U4.18 (IO10), X3.5 (SDA)
TE: U4.15 (IO3), X3.3 (BUSY/TE)
TS1_W: J6.8, R31.2
TS1_W_IO: U2.13 (PB1), U13.16 (COLLECTOR_1)
TS1_Y: J6.7, R30.2
TS1_Y_IO: U2.12 (PB2_(TOSC2)), U13.14 (COLLECTOR_2)
TS2_W: J6.4, R29.2
TS2_W_IO: U2.11 (PB3_(TOSC1)), U13.12 (COLLECTOR_3)
TS2_Y: J6.3, R28.2
TS2_Y_IO: U2.14 (PB0), U13.10 (COLLECTOR_4)
TS3_W: J7.8, R35.2
TS3_W_IO: U2.15 (PC0), U14.16 (COLLECTOR_1)
TS4_W: J7.4, R34.2
TS4_W_IO: U2.16 (PC1), U14.14 (COLLECTOR_2)
TS_INT: U4.17 (IO9), X3.4 (INT)
UART: U2.20 (PA1), U4.28 (IO35), UART.TP
UPDI: J12.1, U2.19 (PA0_(UPDI/!RESET))
USB_D+: J1.A6 (D+), J1.B6 (D+), U4.14 (IO20)
USB_D-: J1.A7 (D-), J1.B7 (D-), U4.13 (IO19)
VIN: D4.A, X1.1
VLV1/2_SW: D2.A, D5.C, R33.2
VLV1/2_SW_IO: R2.1, U2.17 (PC2), U14.12 (COLLECTOR_3)
VLV1_M: J2.1, RV1.2, U6.4 (D2)
VLV1_O: R10.2, U4.33 (IO40)
VLV1_SW: D2.C, J2.4
VLV2_M: J2.5, RV2.1, U5.3 (D1)
VLV2_O: R4.2, U4.32 (IO39)
VLV2_SW: D5.A, J2.8
VLV3/4_SW: D3.C, D6.A, R32.2
VLV3/4_SW_IO: R1.1, U2.18 (PC3), U14.10 (COLLECTOR_4)
VLV3_M: J3.1, RV3.2, U7.4 (D2)
VLV3_O: R5.2, U4.31 (IO38)
VLV3_SW: D3.A, J3.4
VLV4_M: J3.5, RV4.1, U8.3 (D1)
VLV4_O: R6.2, U4.30 (IO37)
VLV4_SW: D6.C, J3.8
V_USB: D1.A, J1.VBUS1 (VBUS), J1.VBUS2 (VBUS)

Notes on the sheet:
3.3V REGULATOR
Strapping: IO0/3/45/46
VALVE CONTROL
RS485
FANCOILS
THERMOSTATS
PUMPS
8.6-10ma / 0.022W
2.3-2.7ma / <0.073W (24-28VAC input)
8.2-11ma / 0.027W

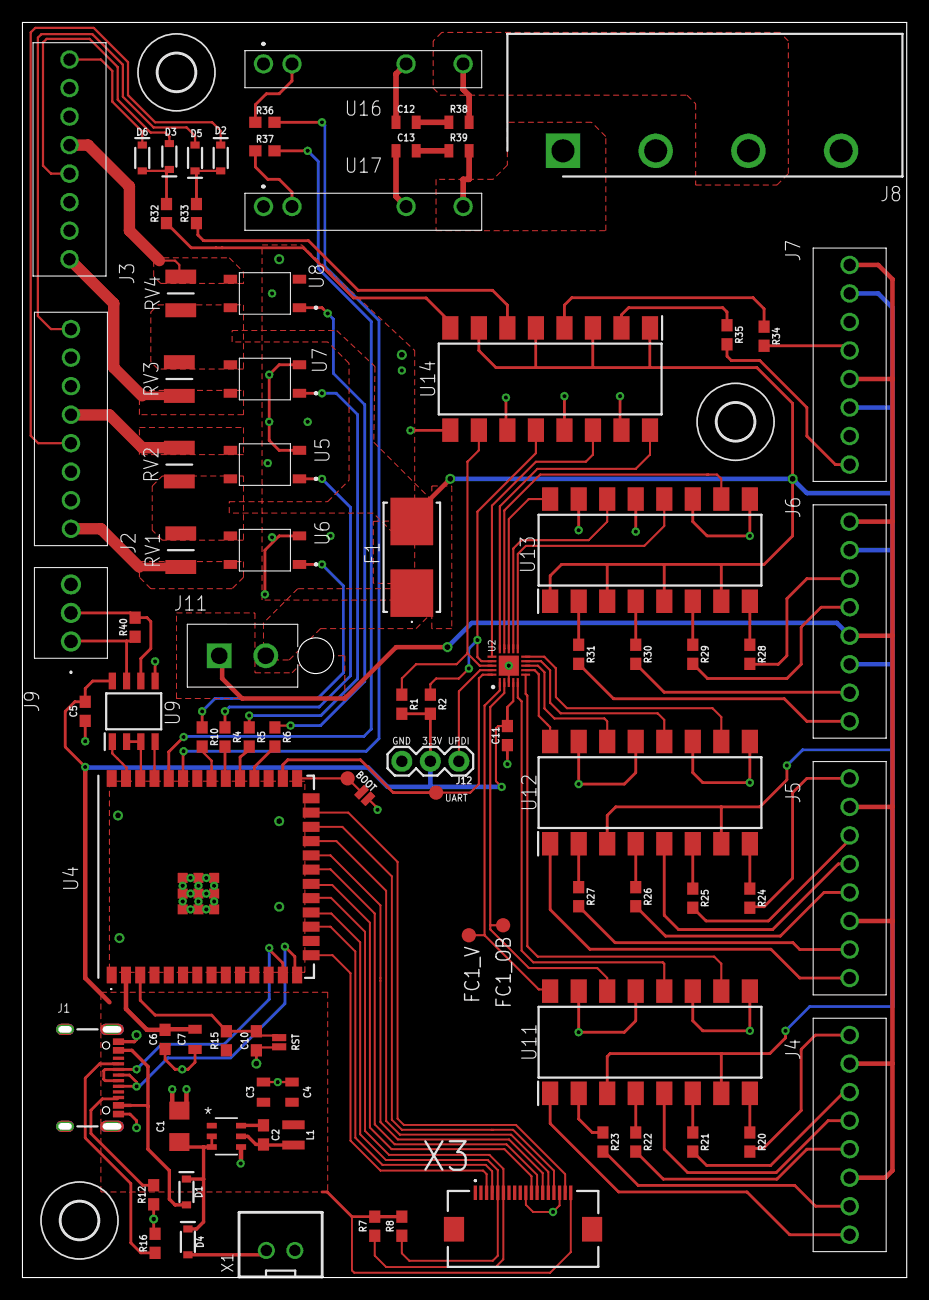
[picture p19: board zone_ctrl.brd from above]

Board: 2 copper layers, 78.7 x 111.8 mm, 91 parts (0 on the bottom side), 111 nets.
