metcalf/hvac_control/eagle/Adafruit 2.8 inch TFT w Capacitive Touch.brd

## EAGLE design eagle/Adafruit 2.8 inch TFT w Capacitive Touch.brd (2024-06-24)

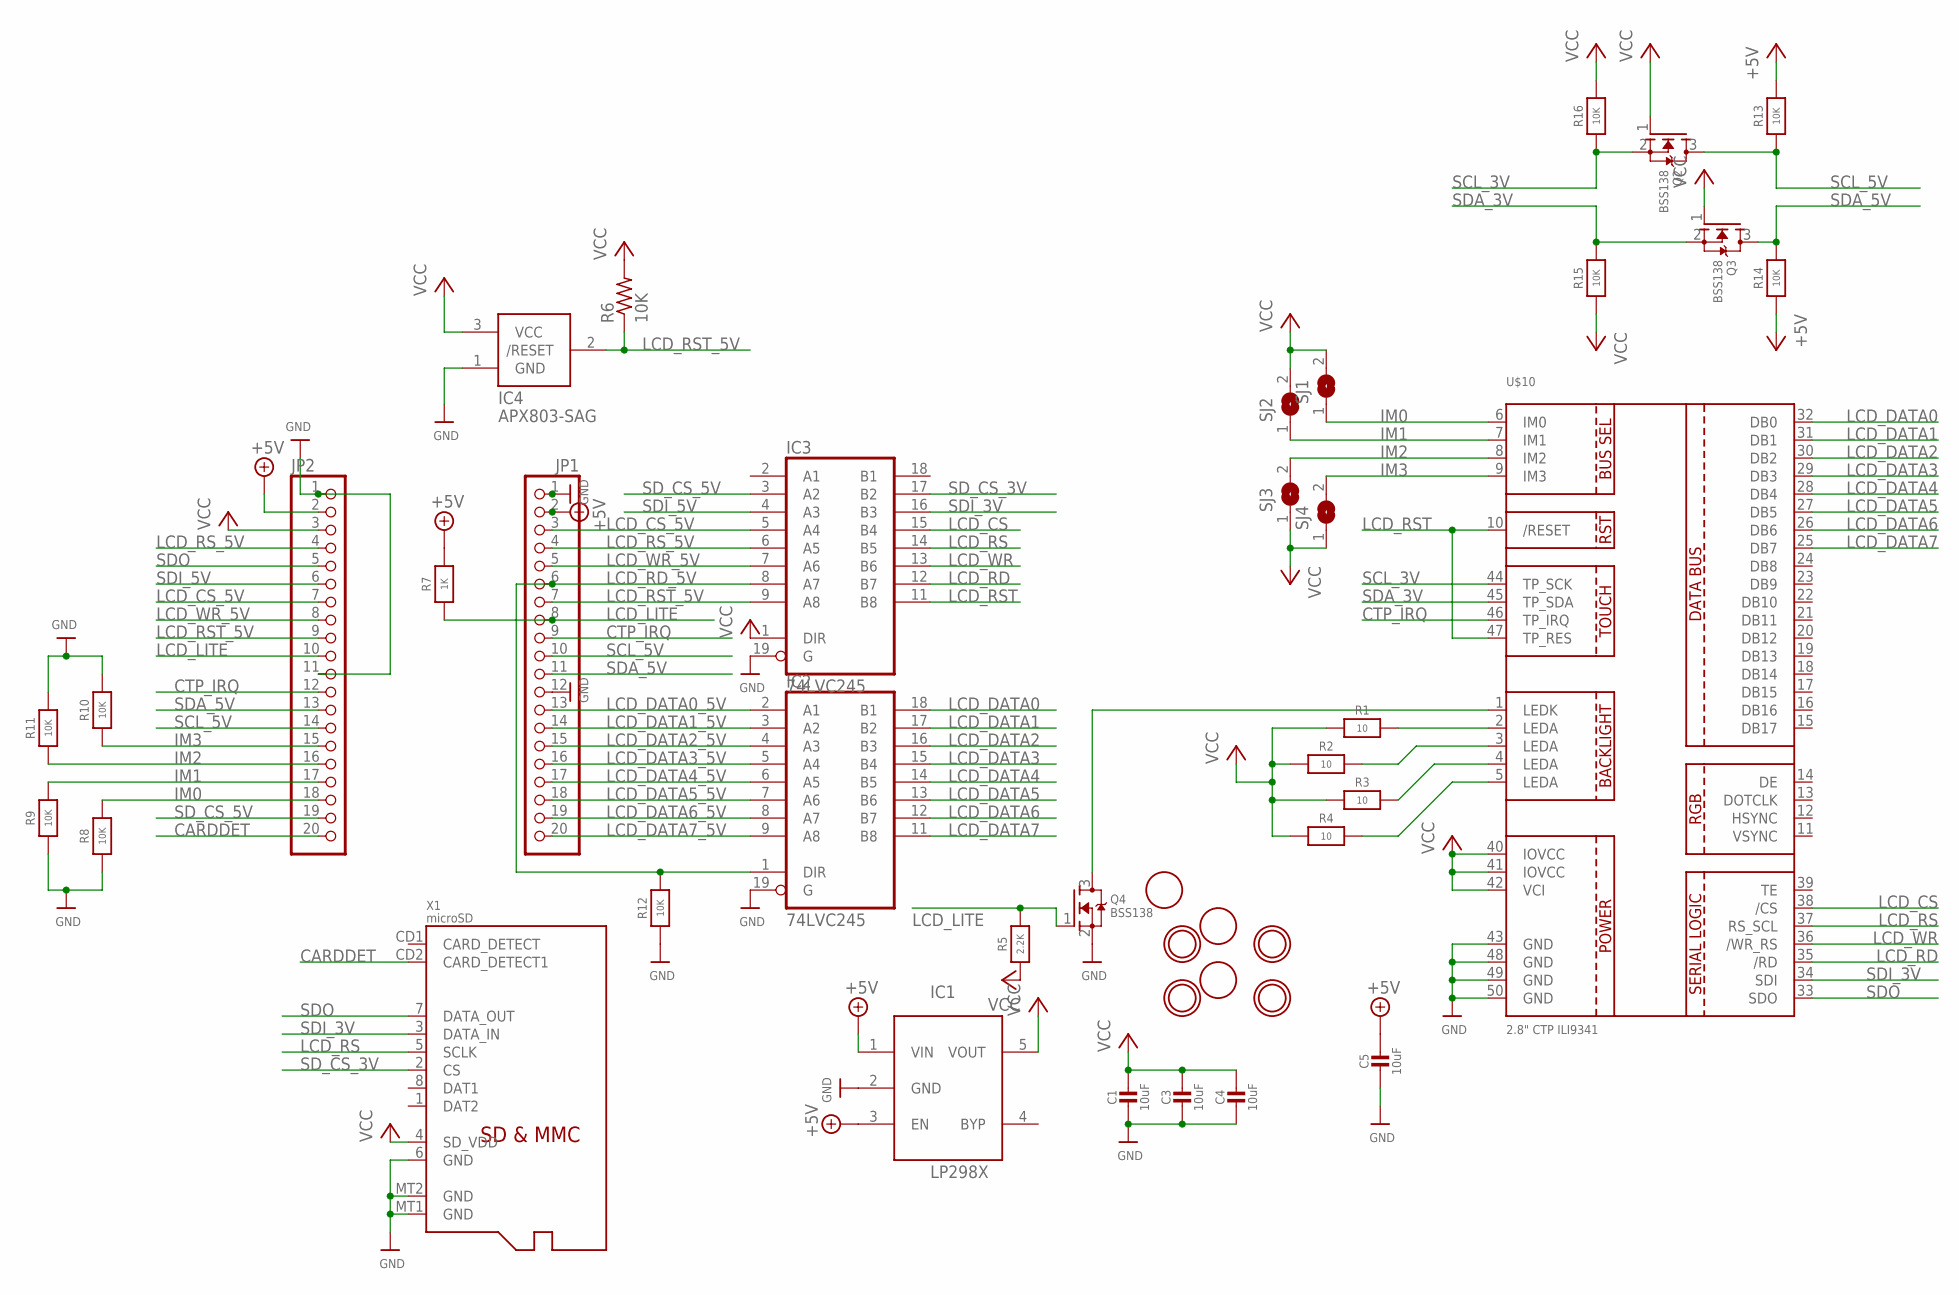
[picture p20: schematic Adafruit 2.8 inch TFT w Capacitive Touch.sch]

Parts:
C1, C3, C4, C5: 10uF; 0805-NO
IC1: MIC5225-3.3; SOT23-5L
IC2, IC3: 74LVC245; SO20W
IC4: APX803-SAG; SOT23
JP1, JP2: HEADER-1X20ROUND; 1X20_ROUND
Q2, Q3, Q4: BSS138; SOT23-WIDE
R1, R2, R3, R4: 10; 0805-NO
R5: 2.2K; 0805-NO
R6: 10K; R0805
R7: 1K; 0805-NO
R8, R9, R10, R11, R12, R13, R14, R15, R16: 10K; 0805-NO
SJ1, SJ2, SJ3, SJ4: SOLDERJUMPER; SOLDERJUMPER_ARROW_NOPASTE
U$7, U$15, U$16, U$17: MOUNTINGHOLE3.0THIN; MOUNTINGHOLE_3.0_PLATEDTHIN
U$9, U$11, U$23: FIDUCIAL; FIDUCIAL_1MM
U$10: 2.8" CTP ILI9341; TFT_2.83IN_240X320_50PIN
X1: microSD; MICROSD

Connections:
+5V: C5.1, IC1.1 (VIN), IC1.3 (EN), JP1.2, JP2.2, R7.2, R13.2, R14.1
CARDDET: JP2.20, X1.CD2 (CARD_DETECT1)
CTP_IRQ: JP1.9, JP2.12, U$10.46 (TP_IRQ)
GND: C1.2, C3.2, C4.2, C5.2, IC1.2 (GND), IC2.10 (GND), IC2.19 (G), IC3.10 (GND), IC3.19 (G), IC4.1 (GND), JP1.1, JP1.12, JP2.1, JP2.11, Q4.2 (S), R8.1, R9.1, R10.2, R11.2, R12.1, U$10.43 (GND), U$10.48 (GND), U$10.49 (GND), U$10.50 (GND), X1.6 (GND), X1.MT1 (GND), X1.MT2 (GND)
IM0: JP2.18, R8.2, SJ1.1, U$10.6 (IM0)
IM1: JP2.17, R9.2, SJ2.1, U$10.7 (IM1)
IM2: JP2.16, R11.1, SJ3.2, U$10.8 (IM2)
IM3: JP2.15, R10.1, SJ4.2, U$10.9 (IM3)
LCD_CS: IC3.15 (B4), U$10.38 (/CS)
LCD_CS_5V: IC3.5 (A4), JP1.3, JP2.7
LCD_DATA0: IC2.18 (B1), U$10.32 (DB0)
LCD_DATA0_5V: IC2.2 (A1), JP1.13
LCD_DATA1: IC2.17 (B2), U$10.31 (DB1)
LCD_DATA1_5V: IC2.3 (A2), JP1.14
LCD_DATA2: IC2.16 (B3), U$10.30 (DB2)
LCD_DATA2_5V: IC2.4 (A3), JP1.15
LCD_DATA3: IC2.15 (B4), U$10.29 (DB3)
LCD_DATA3_5V: IC2.5 (A4), JP1.16
LCD_DATA4: IC2.14 (B5), U$10.28 (DB4)
LCD_DATA4_5V: IC2.6 (A5), JP1.17
LCD_DATA5: IC2.13 (B6), U$10.27 (DB5)
LCD_DATA5_5V: IC2.7 (A6), JP1.18
LCD_DATA6: IC2.12 (B7), U$10.26 (DB6)
LCD_DATA6_5V: IC2.8 (A7), JP1.19
LCD_DATA7: IC2.11 (B8), U$10.25 (DB7)
LCD_DATA7_5V: IC2.9 (A8), JP1.20
LCD_LITE: JP1.8, JP2.10, Q4.1 (G), R5.2, R7.1
LCD_RD: IC3.12 (B7), U$10.35 (/RD)
LCD_RD_5V: IC2.1 (DIR), IC3.8 (A7), JP1.6, R12.2
LCD_RS: IC3.14 (B5), U$10.37 (RS_SCL), X1.5 (SCLK)
LCD_RST: IC3.11 (B8), U$10.10 (/RESET), U$10.47 (TP_RES)
LCD_RST_5V: IC3.9 (A8), IC4.2 (/RESET), JP1.7, JP2.9, R6.1
LCD_RS_5V: IC3.6 (A5), JP1.4, JP2.4
LCD_WR: IC3.13 (B6), U$10.36 (/WR_RS)
LCD_WR_5V: IC3.7 (A6), JP1.5, JP2.8
unnamed: R4.2, U$10.5 (LEDA)
unnamed: R1.2, U$10.2 (LEDA)
unnamed: R2.2, U$10.3 (LEDA)
unnamed: R3.2, U$10.4 (LEDA)
unnamed: Q4.3 (D), U$10.1 (LEDK)
SCL_3V: Q2.2 (S), R16.1, U$10.44 (TP_SCK)
SCL_5V: JP1.10, JP2.14, Q2.3 (D), R13.1
SDA_3V: Q3.2 (S), R15.2, U$10.45 (TP_SDA)
SDA_5V: JP1.11, JP2.13, Q3.3 (D), R14.2
SDI_3V: IC3.16 (B3), U$10.34 (SDI), X1.3 (DATA_IN)
SDI_5V: IC3.4 (A3), JP2.6
SDO: JP2.5, U$10.33 (SDO), X1.7 (DATA_OUT)
SD_CS_3V: IC3.17 (B2), X1.2 (CS)
SD_CS_5V: IC3.3 (A2), JP2.19
VCC: C1.1, C3.1, C4.1, IC1.5 (VOUT), IC2.20 (VCC), IC3.1 (DIR), IC3.20 (VCC), IC4.3 (VCC), JP2.3, Q2.1 (G), Q3.1 (G), R1.1, R2.1, R3.1, R4.1, R5.1, R6.2, R15.1, R16.2, SJ1.2, SJ2.2, SJ3.1, SJ4.1, U$10.40 (IOVCC), U$10.41 (IOVCC), U$10.42 (VCI), X1.4 (SD_VDD)

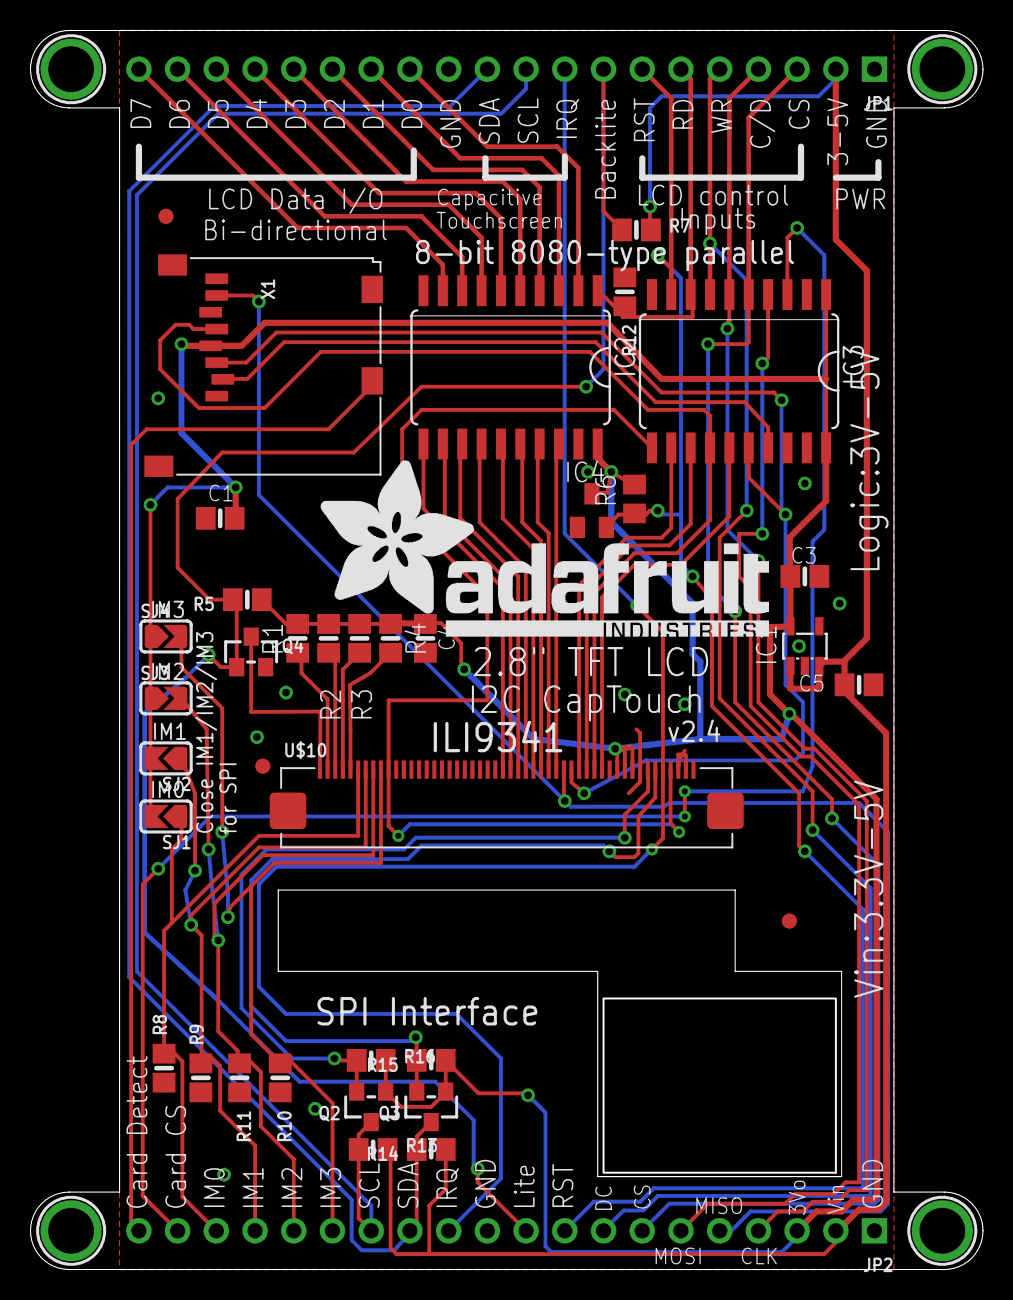
[picture p21: board Adafruit 2.8 inch TFT w Capacitive Touch.brd from above]

Board: 2 copper layers, 62.5 x 81.3 mm, 43 parts (1 on the bottom side), 50 nets.

Other parts of the board:
U$19: ADAFRUIT_TEXT_30MM
