metcalf/hvac_control/controller/components/controller_app/include/ControllerApp.h

#pragma once

#include <cmath>
#include <functional>

#include "AbstractConfigStore.h"
#include "AbstractDemandAlgorithm.h"
#include "AbstractHomeClient.h"
#include "AbstractModbusController.h"
#include "AbstractOTAClient.h"
#include "AbstractSensors.h"
#include "AbstractUIManager.h"
#include "AbstractValveCtrl.h"
#include "AbstractWifi.h"
#include "ControllerDomain.h"
#include "LinearFanCoolAlgorithm.h"
#include "LinearVentAlgorithm.h"
#include "NullAlgorithm.h"
#include "PIDAlgorithm.h"
#include "SetpointHandler.h"

// Keep HVAC on in the same mode for at least this time to avoid excessive valve wear
// and detect potential control system issues.
#define MIN_HVAC_ON_INTERVAL std::chrono::minutes(5)
// Minimum fan speed value (below this, the fan won't reliably start)
#define MIN_FAN_SPEED_VALUE (ControllerDomain::FanSpeed)10
// Minimum time to keep the fan running after it turns on to reduce short cycling
#define MIN_FAN_ON_TIME std::chrono::minutes(15)
// The exhaust fan has a built-in timer so we just hold the output
// for a short time to make sure the fan registers it.
#define EXHAUST_BUTTON_ON_TIME std::chrono::seconds(6)

// After a cold boot the temperature sensor self-heats and readings aren't accurate until
// it stabilizes. For this long after boot we treat the indoor temperature as unreliable
// and heating is disabled (cooling is still allowed since we'll just under-cool while the
// sensor warms up).
#define TEMP_STABILIZE_TIME std::chrono::minutes(15)
// For this long after boot, don't turn the A/C on solely because the outdoor temperature
// is unknown. This gives wifi time to connect and fetch outdoor temperature information.
#define AC_WIFI_CONNECT_WAIT_TIME std::chrono::minutes(1)

// A coil temp below this means the A/C is running, either for another thermostat or for us
// before a restart. Other rooms needing the A/C is a good sign we will too, so with a cold
// coil we don't wait for the indoor or outdoor temp to get high before turning it on.
#define COIL_COLD_TEMP_C ABS_F_TO_C(60.0)
// For this long after boot a cold coil enables the A/C whatever the cooling demand and
// outdoor temp. We lose the built up cooling demand in a restart so we can't rely on it
// to turn the A/C back on if we were the one running it.
#define AC_BOOT_COLD_COIL_TIME std::chrono::minutes(5)
// Turn the A/C on if temp exceeds setpoint by this amount
#define AC_ON_THRESHOLD_C REL_F_TO_C(4.0)
// Turn the A/C on if the outdoor temp is above the setpoint by this amount
// since we want to get ahead of the heat
#define AC_ON_OUT_TEMP_THRESHOLD_C REL_F_TO_C(4.0)
// Turn on the A/C if cooling demand exceeds this and another condition is met
// (indoor or outdoor temp is high enough, or the coil is cold)
#define AC_ON_DEMAND_THRESHOLD 0.3
// Cooling demand is in units of this much cooling, i.e. a demand of 1.0 means we want
// at least this many BTU/hr. This is just a bit above what the fancoil delivers on
// medium since that's when we want to bump up to high.
#define COOL_DEMAND_FULL_BTU_HR 3000.0
// Cooling delivered by the fresh air fan at full speed per degree F that the outdoor temp
// is below the indoor temp. The fan covers as much of the cooling demand as it can and
// the A/C is only asked for the remainder.
#define FAN_COOL_BTU_HR_PER_DEG_F 150.0
// Leave the A/C on until it has gone this long without cooling. Air temp reaching the
// setpoint doesn't mean the structure has cooled, so only hand off to ventilation once
// the room has held without the A/C for a while.
#define AC_OFF_IDLE_TIME std::chrono::hours(1)
// If fan is above this speed, turn on exhaust fan for extra cooling/pressure balance
#define FAN_SPEED_EXHAUST_ON_THRESHOLD (ControllerDomain::FanSpeed)170
// Turn exhaust fan off when fan speed drops below this (hysteresis)
// Note that the fan has a built-in 20m timer after we turn off the relay
#define FAN_SPEED_EXHAUST_OFF_THRESHOLD (ControllerDomain::FanSpeed)140

class ControllerApp {
  public:
    typedef std::function<void()> restartCb_t;
    typedef std::function<bool(AbstractUIManager::Event *, uint16_t)> uiEvtRcv_t;

    ControllerApp(ControllerDomain::Config config, AbstractUIManager *uiManager,
                  AbstractModbusController *modbusController, AbstractSensors *sensors,
                  AbstractValveCtrl *valveCtrl, AbstractWifi *wifi,
                  AbstractConfigStore<ControllerDomain::Config> *cfgStore,
                  AbstractHomeClient *homeCli, AbstractOTAClient *ota, const uiEvtRcv_t &uiEvtRcv,
                  const restartCb_t restartCb, bool tempSensorWarmedUp = true)
        : config_(config), uiManager_(uiManager), modbusController_(modbusController),
          sensors_(sensors), valveCtrl_(valveCtrl), wifi_(wifi), cfgStore_(cfgStore),
          homeCli_(homeCli), ota_(ota), uiEvtRcv_(uiEvtRcv), restartCb_(restartCb),
          fancoilCoolHandler_(fancoilCoolCutoffs_, std::size(fancoilCoolCutoffs_)),
          fancoilHeatHandler_(fancoilHeatCutoffs_, std::size(fancoilHeatCutoffs_)),
          fancoilPBRCoolHandler_(fancoilPBRCoolCutoffs_, std::size(fancoilPBRCoolCutoffs_)),
          fancoilPBRHeatHandler_(fancoilPBRHeatCutoffs_, std::size(fancoilPBRHeatCutoffs_)) {
        ventAlgo_ = new LinearVentAlgorithm();
        // A wider range than the default keeps the fan from jumping to full speed as soon as
        // we're a little above the cooling setpoint.
        coolDemandAlgo_ = new PIDAlgorithm(false, REL_F_TO_C(4.0));

        tempSensorWarmedUp_ = tempSensorWarmedUp;

        updateEquipment(config_.equipment);
        setSystemPower(config_.systemOn);

        // Ensure exhaust fan is off at startup to avoid getting stuck on after resets
        modbusController_->setExhaustFan(false);
    }
    ~ControllerApp() {
        delete ventAlgo_;
        delete heatAlgo_;
        delete coolDemandAlgo_;
    }
    void setConfig(ControllerDomain::Config config);

    void task(bool firstTime = false);
    void bootErr(const char *msg);

    static size_t nMsgIds() { return static_cast<size_t>(ControllerApp::MsgID::_Last); }
    bool clockReady() {
        // Time is after ~2020
        return std::chrono::system_clock::to_time_t(realNow()) > (60 * 60 * 24 * 365 * 50);
    }

    enum class MsgID {
        SystemOff,
        FanOverride,
        TempOverride,
        ACMode,
        Precooling,
        Wifi,
        SensorErr,
        GetFreshAirStateErr,
        SetFreshAirSpeedErr,
        GetMakeupDemandErr,
        SetFancoilErr,
        HomeClientErr,
        ExhaustErr,
        OTA,
        Vacation,
        HVACChangeLimit,
        TempStabilizing,
        _Last,
    };
    enum class FanSpeedReason {
        Unknown,
        Off,
        Override,
        Cool,
        Vent,
        PollOutdoorTemp,
        MakeupAir,
        Continuous,
        MinOnTime,
    };
    enum class SetpointReason {
        Unknown,
        Normal,
        Precooling,
        Override,
        Vacation,
        NoTime,
    };

  protected:
    virtual std::chrono::steady_clock::time_point steadyNow() {
        return std::chrono::steady_clock::now();
    }
    virtual std::chrono::system_clock::time_point realNow() {
        return std::chrono::system_clock::now();
    }

    SetpointReason setpointReason_ = SetpointReason::Unknown;
    FanSpeedReason fanSpeedReason_ = FanSpeedReason::Unknown;

    // When true (e.g. after a clean software restart, or when the user cancels the
    // warmup message) we skip the post-boot temp sensor warmup period since the
    // sensor is treated as already warm.
    bool tempSensorWarmedUp_ = true;

  private:
    using FancoilRequest = ControllerDomain::FancoilRequest;
    using FancoilSpeed = ControllerDomain::FancoilSpeed;
    using SensorData = ControllerDomain::SensorData;
    using FancoilState = ControllerDomain::FancoilState;
    using FreshAirState = ControllerDomain::FreshAirState;
    using Setpoints = ControllerDomain::Setpoints;
    using FanSpeed = ControllerDomain::FanSpeed;
    using HVACState = ControllerDomain::HVACState;
    using Config = ControllerDomain::Config;

    enum class ACMode { Off, On, Standby };

    const char *acModeToS(ACMode acMode) const {
        switch (acMode) {
        case ACMode::Off:
            return "OFF";
        case ACMode::On:
            return "ON";
        case ACMode::Standby:
            return "STBY";
        }

        __builtin_unreachable();
    }

    const char *msgIDToS(MsgID id) const {
        switch (id) {
        case MsgID::SystemOff:
            return "SystemOff";
        case MsgID::FanOverride:
            return "FanOverride";
        case MsgID::TempOverride:
            return "TempOverride";
        case MsgID::ACMode:
            return "ACMode";
        case MsgID::Precooling:
            return "Precooling";
        case MsgID::Wifi:
            return "Wifi";
        case MsgID::SensorErr:
            return "SensorErr";
        case MsgID::GetFreshAirStateErr:
            return "GetFreshAirStateErr";
        case MsgID::SetFreshAirSpeedErr:
            return "SetFreshAirSpeedErr";
        case MsgID::GetMakeupDemandErr:
            return "GetMakeupDemandErr";
        case MsgID::SetFancoilErr:
            return "SetFancoilErr";
        case MsgID::HomeClientErr:
            return "HomeClientErr";
        case MsgID::ExhaustErr:
            return "ExhaustErr";
        case MsgID::OTA:
            return "OTA";
        case MsgID::Vacation:
            return "Vacation";
        case MsgID::HVACChangeLimit:
            return "HVACChangeLimit";
        case MsgID::TempStabilizing:
            return "TempStabilizing";
        case MsgID::_Last:
            return "";
        }

        __builtin_unreachable();
    }

    const char *fanSpeedReasonToS(FanSpeedReason reason) const {
        switch (reason) {
        case FanSpeedReason::Unknown:
            return "unknown";
        case FanSpeedReason::Off:
            return "off";
        case FanSpeedReason::Override:
            return "override";
        case FanSpeedReason::Cool:
            return "cool";
        case FanSpeedReason::Vent:
            return "vent";
        case FanSpeedReason::PollOutdoorTemp:
            return "poll_temp";
        case FanSpeedReason::MakeupAir:
            return "makeup_air";
        case FanSpeedReason::Continuous:
            return "continuous";
        case FanSpeedReason::MinOnTime:
            return "min_on_time";
        }

        __builtin_unreachable();
    }

    const char *setpointReasonToS(SetpointReason reason) const {
        switch (reason) {
        case SetpointReason::Unknown:
            return "unknown";
        case SetpointReason::Normal:
            return "normal";
        case SetpointReason::Precooling:
            return "precooling";
        case SetpointReason::Override:
            return "override";
        case SetpointReason::Vacation:
            return "vacation";
        case SetpointReason::NoTime:
            return "no_time";
        }

        __builtin_unreachable();
    }

    void updateEquipment(ControllerDomain::Config::Equipment equipment);
    void updateACMode(const double coolDemand, const double coolSetpointC, const double inTempC,
                      const double outTempC);
    // True while the indoor temperature sensor is still self-heating after a cold
    // boot and its readings should be treated as unreliable.
    bool tempStabilizing();
    FanSpeed computeFanSpeed(double ventDemand, double coolDemand, bool wantOutdoorTemp);
    void setFanSpeed(ControllerDomain::FanSpeed);
    void setExhaustFan(FanSpeed fanSpeed);
    void handleExhaustControlButton();
    bool pollUIEvent(bool wait);
    void handleCancelMessage(MsgID id);
    HVACState setHVAC(const double heatDemand, const double coolDemand, const FanSpeed fanSpeed);
    void setErrMessageF(MsgID msgID, bool allowCancel, const char *fmt, ...);
    void setMessageF(MsgID msgID, bool allowCancel, const char *fmt, ...);
    void setMessage(MsgID msgID, bool allowCancel, const char *msg);
    void clearMessage(MsgID msgID);
    void checkModbusErrors();
    void handleHomeClient();
    ControllerDomain::FreshAirState getFreshAirState();
    int getScheduleIdx(int offset);
    Setpoints getCurrentSetpoints(double currTempC);
    void setTempOverride(AbstractUIManager::TempOverride tempOverride);
    bool applyScheduleUpdates(const AbstractUIManager::ScheduleUpdate *updates);
    uint16_t localMinOfDay();
    void logState(const ControllerDomain::FreshAirState &freshAirState,
                  const ControllerDomain::SensorData &sensorData, double ventDemand,
                  double fanCoolDemand, double heatDemand, double coolDemand, double acDemand,
                  const ControllerDomain::Setpoints &setpoints,
                  const ControllerDomain::HVACState hvacState, const FanSpeed fanSpeed,
                  const bool exhaustOn);
    void checkWifiState();
    double outdoorTempC() const;
    AbstractDemandAlgorithm *getHeatAlgoForEquipment(ControllerDomain::Config::HVACType type);
    FancoilSpeed getSpeedForDemand(bool cool, double demand);
    bool isCoilCold();
    double fanCoolCapacity(double inTempC, double outTempC) const;
    void setVacation(bool on);
    void setSystemPower(bool on);
    bool allowHVACChange(bool cool, bool on);
    void resetHVACChangeLimit() {
        hvacLastTurnedOn_ = {};
        hvacChangeLimited_ = false;
    }
    const char *hvacModeStr(bool cool, bool on) const;

    Config config_;
    bool vacationOn_ = false;
    AbstractUIManager *uiManager_;
    AbstractModbusController *modbusController_;
    AbstractSensors *sensors_;
    AbstractValveCtrl *valveCtrl_;
    AbstractWifi *wifi_;
    AbstractConfigStore<ControllerDomain::Config> *cfgStore_;
    AbstractHomeClient *homeCli_;
    AbstractOTAClient *ota_;
    uiEvtRcv_t uiEvtRcv_;
    // coolDemandAlgo_ produces the total cooling demand, which the fan covers as much of as
    // it can with the A/C taking the remainder.
    AbstractDemandAlgorithm *ventAlgo_, *coolDemandAlgo_, *heatAlgo_ = NULL;

    // Limit on fan cooling speed by delta to indoor (outdoor - indoor). It's not worth
    // pushing a lot of air for minimal temperature differences.
    const AbstractDemandAlgorithm::LinearRange fanCoolSpeedLimit_ = {
        {REL_F_TO_C(-4), 1.0},
        {REL_F_TO_C(0), 0},
    };
    restartCb_t restartCb_;

    AbstractUIManager::TempOverride tempOverride_;
    int tempOverrideUntilScheduleIdx_ = -1;

    ACMode acMode_ = ACMode::Standby;
    // Last time the A/C was cooling (or turned on), for AC_OFF_IDLE_TIME
    std::chrono::steady_clock::time_point acLastCooled_{};
    // True when the fan is delivering some cooling and more cooling is available if demand
    // increases, in which case it counts as an active output for the cooling demand
    // algorithm. More demand does nothing once the fan is at its limit and the A/C isn't
    // enabled, so we'd just be winding up the integral.
    bool fanCoolingCanIncrease_ = false;

    // Set to steadyNow() on the first task() call so we can disable heating and
    // delay A/C while the temp sensor warms up and wifi connects after boot.
    std::chrono::steady_clock::time_point bootTime_{};

    double rawOutdoorTempC_ = std::nan("");
    std::chrono::steady_clock::time_point lastOutdoorTempUpdate_;

    bool fanIsOn_ = false;
    bool exhaustFanOn_ = false;
    FanSpeed fanOverrideSpeed_;
    uint32_t stoppedPressurePa_ = 0;
    std::chrono::steady_clock::time_point fanOverrideUntil_{}, fanLastStarted_{}, fanLastStopped_{},
        fanMaxSpeedStarted_{}, exhaustOnUntil_{};

    std::chrono::steady_clock::time_point lastStatusLog_{};
    FanSpeedReason lastLoggedFanSpeedReason_ = FanSpeedReason::Unknown;
    HVACState lastLoggedHvacState_ = HVACState::Off;
    FancoilSpeed lastLoggedFancoilSpeed_ = FancoilSpeed::Off;

    std::chrono::steady_clock::time_point hvacLastTurnedOn_{};
    bool hvacLastCool_;
    bool hvacChangeLimited_ = false;
    Setpoints lastSetpoints_{};
    FancoilSpeed lastHvacSpeed_ = FancoilSpeed::Off; // High == valve on

    // Delta from setpoint in the direction we're aiming to correct
    // e.g. when heating, the amount by which the indoor temp is below the setpoint
    class FancoilSetpointHandler : public SetpointHandler<FancoilSpeed, double> {
        using SetpointHandler::SetpointHandler;
    };
    using FancoilCutoff = FancoilSetpointHandler::Cutoff;

    // My best guess is that the levels produce the following % of power (based on some
    // output numbers from other fancoils and comparing fan power consumptions at
    // different levels, note that lower speeds product more output per cfm):
    // Min: 50% (very random guess)
    //Low: 70%
    // Medium: 80%
    // High: 100%
    // I then tried to map this to some reasonable cutoffs. But have since adjusted
    // based on actual behavior.
    static constexpr FancoilCutoff fancoilCoolCutoffs_[] = {
        FancoilCutoff{FancoilSpeed::Off, 0.1},
        FancoilCutoff{FancoilSpeed::Low, AC_ON_DEMAND_THRESHOLD},
        FancoilCutoff{FancoilSpeed::Med, 0.7}, FancoilCutoff{FancoilSpeed::High, 0.99}};
    static constexpr FancoilCutoff fancoilHeatCutoffs_[] = {
        FancoilCutoff{FancoilSpeed::Off, 0.01}, FancoilCutoff{FancoilSpeed::Min, 0.15},
        FancoilCutoff{FancoilSpeed::Low, 0.5}, FancoilCutoff{FancoilSpeed::Med, 0.9}};
    FancoilSetpointHandler fancoilCoolHandler_;
    FancoilSetpointHandler fancoilHeatHandler_;

    static constexpr FancoilCutoff fancoilPBRCoolCutoffs_[] = {
        fancoilCoolCutoffs_[0], fancoilCoolCutoffs_[1], FancoilCutoff{FancoilSpeed::Med, 0.6},
        FancoilCutoff{FancoilSpeed::High, 0.95}};
    static constexpr FancoilCutoff fancoilPBRHeatCutoffs_[] = {
        fancoilCoolCutoffs_[0], FancoilCutoff{FancoilSpeed::Min, 0.15},
        FancoilCutoff{FancoilSpeed::Low, 0.35}, FancoilCutoff{FancoilSpeed::Med, 0.6},
        FancoilCutoff{FancoilSpeed::High, 0.95}};
    FancoilSetpointHandler fancoilPBRCoolHandler_;
    FancoilSetpointHandler fancoilPBRHeatHandler_;
};
