metcalf/hvac_control/controller/main/controller_main.cpp

#include "controller_main.h"

#include <time.h>

#include "esp_log.h"
#include "esp_netif_sntp.h"
#include "esp_system.h"
#include "esp_task.h"
#include "esp_timer.h"
#include "freertos/FreeRTOS.h"
#include "freertos/queue.h"
#include "freertos/task.h"
#include "nvs_flash.h"

#include "AppConfigStore.h"
#include "ControllerApp.h"
#include "ESPOTAClient.h"
#include "ESPWifi.h"
#include "ModbusController.h"
#include "MqttHomeClient.h"
#include "NetworkTaskManager.h"
#include "OtaTask.h"
#include "Sensors.h"
#include "UIManager.h"
#include "ValveCtrl.h"
#include "remote_logger.h"
#include "rtc-rx8111.h"

#define INIT_ERR_RESTART_DELAY_TICKS pdMS_TO_TICKS(60 * 1000)

#define UI_TASK_PRIO ESP_TASKD_EVENT_PRIO
#define SENSOR_TASK_PRIO ESP_TASK_MAIN_PRIO
#define MODBUS_TASK_PRIO SENSOR_TASK_PRIO + 1
#define MAIN_TASK_PRIO MODBUS_TASK_PRIO + 1

#define MAIN_TASK_STACK_SIZE 4096
#define SENSOR_TASK_STACK_SIZE 4096
#define MODBUS_TASK_STACK_SIZE 4096
#define UI_TASK_STACK_SIZE 8192

#define SENSOR_RETRY_INTERVAL_TICKS pdMS_TO_TICKS(1 * 1000)
#define SENSOR_UPDATE_INTERVAL_TICKS pdMS_TO_TICKS(30 * 1000)
#define CLOCK_POLL_PERIOD_TICKS pdMS_TO_TICKS(100)
#define CLOCK_WAIT_TICKS pdMS_TO_TICKS(10 * 1000)
#define RTC_BOOT_TIME_TICKS pdMS_TO_TICKS(40)
#define CONNECT_WAIT_INTERVAL_TICKS pdMS_TO_TICKS(10 * 1000)
#define HEAP_LOG_INTERVAL std::chrono::minutes(15)

#define POSIX_TZ_STR "PST8PDT,M3.2.0/2:00:00,M11.1.0/2:00:00"

static const char *TAG = "MAIN";

using Config = ControllerDomain::Config;

static ControllerApp *app_;
static ModbusController *modbusController_;
static UIManager *uiManager_;
static ValveCtrl valveCtrl_;
static Sensors sensors_;
static QueueHandle_t uiEvtQueue_;
static ESPWifi wifi_;
static AppConfigStore appConfigStore_;
static MqttHomeClient *homeCli_;
static ESPOTAClient *ota_;
static NetworkTaskManager *netTaskMgr_;

void sensorTask(void *sensors) {
    while (1) {
        if (((Sensors *)sensors)->poll()) {
            vTaskDelay(SENSOR_UPDATE_INTERVAL_TICKS);
        } else {
            vTaskDelay(SENSOR_RETRY_INTERVAL_TICKS);
        }
    }
}

void uiTask(void *uiManager) {
    while (1) {
        uint32_t delayMs = ((UIManager *)uiManager)->handleTasks();
        if (delayMs < portTICK_PERIOD_MS) {
            taskYIELD();
        } else {
            vTaskDelay(pdMS_TO_TICKS(delayMs));
        }
    }
}

void mainTask(void *app) {
    bool first = true;

    log_heap_stats();
    wifi_.logDiagnostics();
    std::chrono::steady_clock::time_point last_logged_heap = std::chrono::steady_clock::now();

    // Wait a bit of time to get a valid clock before loading
    for (int i = 0; i < (CLOCK_WAIT_TICKS / CLOCK_POLL_PERIOD_TICKS); i++) {
        if (app_->clockReady()) {
            break;
        }
        vTaskDelay(CLOCK_POLL_PERIOD_TICKS);
    }
    ESP_LOGI(TAG, "clock ready, starting app");

    while (1) {
        ((ControllerApp *)app)->task(first);
        first = false;

        std::chrono::steady_clock::time_point now = std::chrono::steady_clock::now();
        if ((now - last_logged_heap) > HEAP_LOG_INTERVAL) {
            log_heap_stats();
            wifi_.logDiagnostics();
            last_logged_heap = now;
        }
    }
}

void otaMsgCb(const char *msg) {
    if (strlen(msg) > 0) {
        uiManager_->setMessage(static_cast<uint8_t>(ControllerApp::MsgID::OTA), false, msg);
    } else {
        uiManager_->clearMessage(static_cast<uint8_t>(ControllerApp::MsgID::OTA));
    }
}

void modbusTask(void *mb) { ((ModbusController *)mb)->task(); }

void uiEvtCb(UIManager::Event &evt) { xQueueSend(uiEvtQueue_, &evt, portMAX_DELAY); }

bool uiEvtRcv(UIManager::Event *evt, uint waitMs) {
    return xQueueReceive(uiEvtQueue_, evt, pdMS_TO_TICKS(waitMs)) == pdTRUE;
}

void setRTC(struct timeval *tv) {
    struct tm dt;
    gmtime_r(&tv->tv_sec, &dt);
    esp_err_t err = rtc_rx8111_set_time(&dt);
    if (err != ESP_OK) {
        ESP_LOGE(TAG, "Error setting RTC time: %d", err);
    } else {
        ESP_LOGD(TAG, "Set RTC time(%04d-%02d-%02d %02d:%02d:%02d)", dt.tm_year + 1900,
                 dt.tm_mon + 1, dt.tm_mday, dt.tm_hour, dt.tm_min, dt.tm_sec);
    }
}

esp_err_t setupRTC() {
    bool hasTime = false;

    TickType_t ticks = xTaskGetTickCount();
    if (RTC_BOOT_TIME_TICKS > ticks) {
        ESP_LOGI(TAG, "Waiting for RTC to start");
        vTaskDelay(RTC_BOOT_TIME_TICKS - ticks);
    }

    esp_err_t err = rtc_rx8111_init_client(&hasTime);
    if (err != ESP_OK) {
        return err;
    }

    if (hasTime) {
        struct tm dt;
        err = rtc_rx8111_get_time(&dt);
        if (err != ESP_OK) {
            ESP_LOGD(TAG, "Error retrieving time from RTC");
            return err;
        }
        ESP_LOGI(TAG, "Loaded time from RTC (%04d-%02d-%02d %02d:%02d:%02d)", dt.tm_year + 1900,
                 dt.tm_mon + 1, dt.tm_mday, dt.tm_hour, dt.tm_min, dt.tm_sec);

        timeval tv;
        tv.tv_sec = mktime(&dt);
        settimeofday(&tv, NULL);
    } else {
        ESP_LOGI(TAG, "RTC doesn't have valid time");
    }

    wifi_.setSNTPCallback(setRTC);

    return ESP_OK;
}

void __attribute__((format(printf, 1, 2))) bootErr(const char *fmt, ...) {
    char bootErrMsg[UI_MAX_MSG_LEN];

    va_list args;
    va_start(args, fmt);
    vsnprintf(bootErrMsg, sizeof(bootErrMsg), fmt, args);
    va_end(args);

    app_->bootErr(bootErrMsg);
    vTaskDelay(INIT_ERR_RESTART_DELAY_TICKS);
    esp_restart();
}

extern "C" void controller_main() {
    esp_err_t err;

    // Initialize NVS
    err = nvs_flash_init();
    if (err == ESP_ERR_NVS_NO_FREE_PAGES || err == ESP_ERR_NVS_NEW_VERSION_FOUND) {
        ESP_ERROR_CHECK(nvs_flash_erase());
        err = nvs_flash_init();
    }
    ESP_ERROR_CHECK(err);

    uiEvtQueue_ = xQueueCreate(10, sizeof(UIManager::Event));

    Config config;
    err = appConfigStore_.load(&config);
    if (err != ESP_OK) {
        bootErr("Failed to load config: %d", err);
    }
    ota_ = new ESPOTAClient("controller", otaMsgCb, UI_MAX_MSG_LEN);
    uiManager_ = new UIManager(config, ControllerApp::nMsgIds(), uiEvtCb);
    UIManager::setEventsInst(uiManager_);
    uiManager_->setFirmwareVersion(ota_->currentVersion());
    modbusController_ = new ModbusController();
    valveCtrl_.init();

    homeCli_ = new MqttHomeClient(config.wifi.logName, uiEvtCb);

    // On a clean software restart (e.g. OTA or an intentional reboot) the temp
    // sensor is already warm, so skip the post-boot warmup. After a power-on or a
    // crash, treat the temperature as unreliable until the sensor stabilizes.
    bool tempSensorWarmedUp = esp_reset_reason() == ESP_RST_SW;
    ESP_LOGI(TAG, "Reset reason: %d", esp_reset_reason());

    app_ = new ControllerApp(config, uiManager_, modbusController_, &sensors_, &valveCtrl_, &wifi_,
                             &appConfigStore_, homeCli_, ota_, uiEvtRcv, esp_restart,
                             tempSensorWarmedUp);
    xTaskCreate(uiTask, "uiTask", UI_TASK_STACK_SIZE, uiManager_, UI_TASK_PRIO, NULL);

    setenv("TZ", POSIX_TZ_STR, 1);
    tzset();

    err = setupRTC(); // Do this before starting wifi to avoid races with NTP
    if (err != ESP_OK) {
        bootErr("RTC init error: %d", err);
    }

    wifi_.init(config.wifi.logName);
    wifi_.connect(config.wifi.ssid, config.wifi.password);
    remote_logger_init(config.wifi.logName, default_log_host);
    // LOGW immediately after remote_logger_init gives us an early remote log line
    // to note a restart
    ESP_LOGW(TAG, "Wifi started, booting app");
    netTaskMgr_ = new NetworkTaskManager(wifi_);
    netTaskMgr_->addTask(otaTaskFn, ota_);

    // Start MQTT client
    homeCli_->start();

    if (!sensors_.init()) {
        bootErr("Sensor init error");
    }
    ESP_LOGI(TAG, "sensors initialized");

    err = modbusController_->init();
    if (err != ESP_OK) {
        bootErr("Modbus init error: %d", err);
    }
    ESP_LOGI(TAG, "modbus initialized");

    xTaskCreate(sensorTask, "sensorTask", SENSOR_TASK_STACK_SIZE, &sensors_, SENSOR_TASK_PRIO,
                NULL);
    xTaskCreate(modbusTask, "modbusTask", MODBUS_TASK_STACK_SIZE, modbusController_,
                MODBUS_TASK_PRIO, NULL);
    netTaskMgr_->start();

    // Wait for sensors to have valid data
    while (std::isnan(sensors_.getLatest().tempC)) {
        vTaskDelay(pdMS_TO_TICKS(100));
    }

    xTaskCreate(mainTask, "mainTask", MAIN_TASK_STACK_SIZE, app_, MAIN_TASK_PRIO, NULL);
}
