metcalf/hvac_control/controller/components/controller_app/src/PIDAlgorithm.cpp

#include "PIDAlgorithm.h"

#include "esp_log.h"

double PIDAlgorithm::update(const ControllerDomain::SensorData &sensorData,
                            const ControllerDomain::Setpoints &setpoints, const double outdoorTempC,
                            std::chrono::steady_clock::time_point now, bool outputActive) {
    double setpoint_c = isHeater_ ? setpoints.heatTempC : setpoints.coolTempC;

    double deltaC = setpoint_c - sensorData.tempC;
    int sign = isHeater_ ? 1 : -1;

    // Reset the integral when the setpoint moves in the direction that reduces demand, so
    // leftover integral doesn't overshoot the new setpoint. Moves that increase demand keep
    // it, since we still need at least as much output as before. This also keeps a ramping
    // setpoint (e.g. precooling) from resetting it every update and leaving only the P term.
    if (sign * (setpoint_c - lastSetpointC_) < 0) {
        i_ = 0;
    }
    lastSetpointC_ = setpoint_c;

    return getDemand(sign * deltaC, now, outputActive);
}

double PIDAlgorithm::getDemand(double deltaC, std::chrono::steady_clock::time_point now,
                               bool outputActive) {
    double err = deltaC / pRangeC_;

    std::chrono::seconds deltaS =
        std::min(std::chrono::duration_cast<std::chrono::seconds>(now - lastTime_), maxInterval_);
    lastTime_ = now;

    double iBefore = i_;

    // Do not integrate when the output is not active to avoid windup close to setpoint
    // causing fans to oscillate on/off. We continue to integrate negative
    // errors since we want to keep recovery from overshoot smooth.
    if (deltaC < 0 || outputActive) {
        i_ += err * deltaS.count();
    }
    double iAfterAdd = i_;
    // Clamp the integral to reduce windup
    i_ = clamp(i_, 0.0, tiSecs_ * maxIDemand_); // Keep iDemand <= maxIDemand_
    double iAfterClamp1 = i_;
    i_ = clamp(i_, 0.0, tiSecs_ * (1 - err)); // Keep err + iDemand <= 1
    double iAfterClamp2 = i_;

    double iDemand = (i_ / tiSecs_);
    double demand = clamp(err + iDemand);

    ESP_LOGD("PID",
             "%s deltaC: %0.2f, demand: %0.2f err: %0.2f i_demand: %0.2f iBefore:%0.2f "
             "iAfterAdd:%0.2f "
             "iAfterClamp1:%0.2f iAfterClamp2:%0.2f",
             isHeater_ ? "HEAT" : "COOL", deltaC, demand, err, iDemand, iBefore, iAfterAdd,
             iAfterClamp1, iAfterClamp2);

    return demand;
}
