metcalf/hvac_control/controller/components/controller_app/include/PIDAlgorithm.h

#pragma once

#include "AbstractDemandAlgorithm.h"

#include <chrono>

class PIDAlgorithm : public AbstractDemandAlgorithm {
  public:
    PIDAlgorithm(bool isHeater, double pRangeC = REL_F_TO_C(2.0), double maxIDemand = 0.5,
                 double tiSecs = 30 * 60,
                 std::chrono::seconds maxInterval = std::chrono::minutes(10))
        : isHeater_(isHeater), pRangeC_(pRangeC), maxIDemand_(maxIDemand), tiSecs_(tiSecs),
          maxInterval_(maxInterval) {};

    double update(const ControllerDomain::SensorData &sensorData,
                  const ControllerDomain::Setpoints &setpoints, const double outdoorTempC,
                  std::chrono::steady_clock::time_point now, bool outputActive) override;

  private:
    // Setpoint changes at least this large reset the integral regardless of direction
    static constexpr double SETPOINT_STEP_C = REL_F_TO_C(0.5);

    const bool isHeater_;
    const double pRangeC_, maxIDemand_, tiSecs_;
    double i_ = 0, lastSetpointC_ = std::nan("");
    std::chrono::steady_clock::time_point lastTime_;
    const std::chrono::seconds maxInterval_;

    double getDemand(double deltaC, std::chrono::steady_clock::time_point now, bool outputActive);

    double clamp(double value, double minValue = 0, double maxValue = 1) {
        return std::max(minValue, std::min(value, maxValue));
    }
};
