metcalf/hvac_control/controller/components/controller_app/src/ValveAlgorithm.cpp

#include "ValveAlgorithm.h"

double ValveAlgorithm::update(const ControllerDomain::SensorData &sensorData,
                              const ControllerDomain::Setpoints &setpoints,
                              const double outdoorTempC,
                              std::chrono::steady_clock::time_point now, bool outputActive) {
    double delta;
    if (isHeater_) {
        delta = setpoints.heatTempC - sensorData.tempC;
    } else {
        delta = sensorData.tempC - setpoints.coolTempC;
    }

    if (isOn_) {
        if (delta < offThresholdC_) {
            isOn_ = false;
        }
    } else if (delta > onThresholdC_) {
        isOn_ = true;
    }

    return isOn_ ? 1 : 0;
}
