metcalf/hvac_control/zone_controller/components/out_ctrl/src/ValveStateManager.cpp

#include "ValveStateManager.h"

void ValveStateManager::handleValvePair(ValveState *states, ValveState *pastStates,
                                        const ValveSWState sw) {
    // Only operate one valve at a time, in either direction so we can track things
    // with the single sw
    int expectOpen = 0;
    for (int i = 0; i < 2; i++) {
        if (pastStates[i].on()) {
            expectOpen++;
        }
    }

    bool allSet = (expectOpen == static_cast<int>(sw));
    bool canAct = allSet;

    for (int i = 0; i < 2; i++) {
        if (states[i].target != pastStates[i].target) {
            if (canAct || pastStates[i].action == ValveAction::Act) {
                // Either OK to start acting or we were already acting
                states[i].action = ValveAction::Act;
                canAct = false;
            } else if (pastStates[i].action == ValveAction::Wait) {
                // If we never actually started acting, we can just revert to Set
                states[i].action = ValveAction::Set;
            } else {
                states[i].action = ValveAction::Wait;
            }
        } else if (allSet) {
            if (pastStates[i].action == ValveAction::Wait) {
                states[i].action = ValveAction::Act;
            } else {
                states[i].action = ValveAction::Set;
            }
        } else {
            states[i].action = pastStates[i].action;
        }
    }
}

void ValveStateManager::update(ValveState *valves, const ValveSWState valveSW[2]) {
    handleValvePair(valves, pastStates_, valveSW[0]);
    handleValvePair(&valves[2], &pastStates_[2], valveSW[1]);

    for (int i = 0; i < 4; i++) {
        pastStates_[i] = valves[i];
    }
}
