metcalf/hvac_control/shared_libs/fresh_air_clients/src/bme280_client.cpp

#include "bme280_client.h"

// Need this define to support variable delay
#define __DELAY_BACKWARD_COMPATIBLE__

#include <TinyI2CMaster.h>
#include <assert.h>
#include <avr/io.h>
#include <util/delay.h>

#define F_SCL 100000 // 100khz
#define MIN_PRESSURE_PA 87000

uint16_t bme_period_ms_;
static uint8_t bme_dev_addr_ = BME280_I2C_ADDR_PRIM;
struct bme280_dev bme_dev_;

void bme280_init() {
    int8_t rslt;

    bme_dev_.intf = BME280_I2C_INTF;
    bme_dev_.intf_ptr = &bme_dev_addr_;
    bme_dev_.read = bme280_i2c_read;
    bme_dev_.write = bme280_i2c_write;
    bme_dev_.delay_us = bme280_delay_us;

    TinyI2C.init();

    rslt = bme280_init(&bme_dev_);
    assert(rslt == BME280_OK);

    struct bme280_settings settings = {
        .osr_p = BME280_OVERSAMPLING_1X,
        .osr_t = BME280_OVERSAMPLING_1X,
        .osr_h = BME280_OVERSAMPLING_1X,
        .filter = BME280_FILTER_COEFF_2,
        .standby_time = BME280_STANDBY_TIME_1000_MS,
    };
    rslt = bme280_set_sensor_settings(BME280_SEL_ALL_SETTINGS, &settings, &bme_dev_);
    assert(rslt == BME280_OK);

    rslt = bme280_set_sensor_mode(BME280_POWERMODE_NORMAL, &bme_dev_);
    assert(rslt == BME280_OK);
};

int8_t bme280_get_latest(int16_t *temp, uint16_t *hum, uint16_t *pres) {
    struct bme280_data data {};
    int8_t rslt = bme280_get_sensor_data(BME280_ALL, &data, &bme_dev_);
    if (rslt != 0) {
        return rslt;
    }

    *temp = (int16_t)data.temperature; // 0.01C
    // Convert from Q22.10 to Q23.9 to fit in uint_16 (truncating to Q7.9)
    // The humidity range is 0-100% so we only need 7 bits left of the decimal
    *hum = (uint16_t)(data.humidity >> 1);
    // Convert from Pa to (Pa - 87000) to fit into atmospheric range
    // Pa pressure range = 87,000 - 108,500 = 21,500
    if (data.pressure < MIN_PRESSURE_PA) {
        *pres = 0;
    } else {
        data.pressure -= MIN_PRESSURE_PA;
        if (data.pressure > UINT16_MAX) {
            *pres = UINT16_MAX;
        } else {
            *pres = data.pressure;
        }
    }

    return 0;
}

BME280_INTF_RET_TYPE bme280_i2c_read(uint8_t reg_addr, uint8_t *reg_data, uint32_t length,
                                     void *intf_ptr) {

    if (!TinyI2C.start(*(uint8_t *)intf_ptr, 0)) {
        return BME280_E_COMM_FAIL;
    }

    if (!TinyI2C.write(reg_addr)) {
        return BME280_E_COMM_FAIL;
    }

    if (!TinyI2C.restart(*(uint8_t *)intf_ptr, length)) {
        return BME280_E_COMM_FAIL;
    }

    for (size_t i = 0; i < length; i++) {
        reg_data[i] = TinyI2C.read();
    }

    TinyI2C.stop();

    return BME280_OK;
}

BME280_INTF_RET_TYPE bme280_i2c_write(uint8_t reg_addr, const uint8_t *reg_data, uint32_t length,
                                      void *intf_ptr) {
    if (!TinyI2C.start(*(uint8_t *)intf_ptr, 0)) {
        return BME280_E_COMM_FAIL;
    }

    for (size_t i = 0; i < length; i++) {
        if (!TinyI2C.write(reg_addr + i)) {
            return BME280_E_COMM_FAIL;
        }

        if (!TinyI2C.write(reg_data[i])) {
            return BME280_E_COMM_FAIL;
        }
    }

    TinyI2C.stop();

    return BME280_OK;
}

void bme280_delay_us(uint32_t period_us, void *intf_ptr) { _delay_us(period_us); }
