metcalf/hvac_control/controller/components/controller_app/include/AbstractHomeClient.h

#pragma once

#include <chrono>

#include "ControllerDomain.h"

class AbstractHomeClient {
  public:
    enum class Error {
        OK,
        NotRun,
        FetchError,
        ParseError,
    };
    struct HomeState {
        bool vacationOn;
        std::chrono::system_clock::time_point weatherObsTime;
        double weatherTempC;
        int16_t aqi;
        Error err;
    };

    virtual ~AbstractHomeClient() {}

    virtual HomeState state() = 0;

    virtual void updateClimateState(bool systemOn, ControllerDomain::HVACState hvacState,
                                    ControllerDomain::FanSpeed fanSpeed,
                                    ControllerDomain::FancoilSpeed fancoilSpeed, double inTempC,
                                    double highTempC, double lowTempC) {};
    virtual void updateStaticPressure(uint32_t pressurePa) {};
    virtual void updateSchedules(const ControllerDomain::Config::Schedule *schedules) {};
    virtual void updateName(const char *name) {};

  protected:
    HomeState state_{.err = Error::NotRun};
};
