metcalf/hvac_control/controller/components/controller_app/src/LinearFanCoolAlgorithm.cpp

#include "LinearFanCoolAlgorithm.h"

double LinearFanCoolAlgorithm::update(const SensorData &sensorData, const Setpoints &setpoints,
                                      const double outdoorTempC,
                                      std::chrono::steady_clock::time_point now, bool outputActive) {
    return indoorTempCoolingRange_.getOutput(setpoints.coolTempC - sensorData.tempC);
}
