metcalf/hvac_control/zone_controller/components/out_ctrl/include/BaseOutIO.h

#pragma once

#define NUM_VALVES 4

class BaseOutIO {
  public:
    virtual void setZonePump(bool on) = 0;
    virtual void setFancoilPump(bool on) = 0;
    virtual void setValve(int idx, bool on) = 0;
};
