metcalf/hvac_control/(commit log)

2024-01-03 compiling freemodbus with errors
    [main.cpp]
2024-01-03 freemodbus timer implementation
2024-01-03 move freemodbus to shared library
    [mcf523x-simple.cfg, mcf523x.cfg, memory.ods, str71x_wig.cfg]
2024-01-03 BME280 driver
2024-01-04 Add Tiny I2C
2024-01-17 Working zone_io valve_sw
2024-01-17 share fixes from zone_io to other projects
    [main.c, main.cpp]
2024-01-17 Switch esp-modbus to released version
2024-01-18 can poll fan control over modbus
2024-01-19 copy fixes to fresh_air_control
    [main.cpp, modbus_client.cpp, modbus_client.h]
2024-01-22 Switch BME280 address
2024-01-24 include scd40 driver
2024-02-06 controller compiles
    [16mb_ota.csv]
2024-02-20 Fix hardware interfaces, mem allocation, points
    [Sensors.cpp, bme280_client.cpp, co2_client.cpp, controller_main.cpp, init_display.h]
2024-02-21 don't track sdkconfig backups
2024-02-22 Working fancoil/makeup board and tester
2024-02-29 WIP new sensor implementation
2024-02-29 Import rx8111 RTC linux driver verbatim
2024-03-01 New config architecture, co2 calibration, some UI improvements
2024-03-04 Add support for 2nd valve sw input pin
2024-03-23 Working RTC and new temp sensor, board rev2
2024-03-23 some co2 calibration tweaks
2024-03-25 Tests and fixes for co2 calibration
2024-03-25 Include hardware files
    [20240102-fresh_air_control.brd, 20240102-fresh_air_control.sch, controller-rev1.1.brd, controller-rev1.1.sch, controller.brd, controller.csv, controller.sch, fancoil.brd]
2024-03-25 Remove old eagle files now that we have git history
    [20240102-fresh_air_control.brd, 20240102-fresh_air_control.sch, 202403-controller-rev2.brd, 202403-controller-rev2.sch, 202403-zone_ctrl.brd, 202403-zone_ctrl.sch, controller.brd, controller.csv]
2024-04-06 more testing and fixing
    [ESPOutIO.cpp, SleepManager.cpp, main.c, zc_main.cpp, zone_io_client.cpp]
2024-06-24 latest boards and cases
    [Adafruit 2.8 inch TFT w Capacitive Touch.brd, Adafruit 2.8 inch TFT w Capacitive Touch.sch, controller.brd, controller_bottom.stl, controller_bottom_v2.stl, controller_bottom_v3.stl, controller_top.stl, controller_top_v2.stl]
2024-07-08 update boards and labeling
    [20240705-label-plate.dxf, label_alignment.dxf, touch_panel_bracket.dxf, zone_ctrl.brd]
2024-07-10 Bump UI
    [label_alignment.dxf]
2024-07-10 Initial pid simulator
2024-07-11 somewhat working pid sim
2024-07-12 simple fan cooling
2024-08-22 pid control wip
2024-09-04 Implement filter static pressure sensing
2024-09-09 fresh air control updates
    [fresh_air_control.brd, fresh_air_control.sch]
2024-09-10 Simplify PID simulation code
2024-09-11 Incorporate time into PID integration
2024-09-17 more pid algo simplification
2024-09-17 mostly working demand-based modulo linker issues
    [ModbusClient.cpp, controller_main.cpp]
2024-09-21 PID passes tests
2024-11-16 WIP switch to pulling weather from home assistant
2024-11-21 WIP updates and bug fixes
    [16mb_ota.csv]
2024-11-22 working remote logger, some fixes
    [controller_main.cpp, main.c]
2024-11-25 Fixed crash on formatting issue
    [controller_main.cpp]
2024-11-30 NetworkTaskManager; Mostly working HVAC switching limits, failing tests
    [ControllerApp.cpp, ControllerApp.h, controller_main.cpp, zc_main.cpp]
2024-12-09 Fix NTM init and OTA rollback
    [controller_main.cpp, zc_main.cpp]
2025-06-11 mostly controller bug and test fixes
    [AbstractValveCtrl.h, ControllerApp.cpp, ControllerApp.h, ModbusClient.cpp, ValveCtrl.cpp]
2025-06-13 system power and fresh air ID bugs
    [ControllerApp.cpp, ControllerApp.h, ModbusClient.cpp, ModbusController.cpp]
2025-06-13 Reset PID integral when setpoint changes and make some logic clearer
    [PIDAlgorithm.cpp, PIDAlgorithm.h]
2025-07-09 Fix changing equipment config
    [ControllerApp.cpp, ControllerApp.h]
2025-07-09 Add turn on hysteresis to fan
2025-07-09 Tweak parameters to reduce short cycling more
    [PIDAlgorithm.h]
2025-07-10 fix bug in windup deadzone
    [PIDAlgorithm.cpp]
2025-07-10 debug pid
2025-07-10 Tune fan parameters a bit more
2025-07-10 fix bug preventing OTA
    [zc_main.cpp]
2025-07-10 try to talk to real heatpump
2025-07-12 Fix out of bounds access bug
    [ControllerApp.cpp]
2025-07-12 use std::size other places to reduce risk of bugs
    [ModbusClient.cpp]
2025-07-12 start swapping A/B pins
    [zone_ctrl.brd, zone_ctrl.sch]
2025-07-12 add restart button
2025-07-12 Fix IncreasesFanSpeedOverTime and Precooling tests for new parameters
    [PIDAlgorithm.cpp]
2025-07-12 Put the restart button label on the button
2025-07-13 finish flipping RS485A/B
    [controller-rev1.1.brd, controller-rev1.1.sch, controller.brd, controller.sch, fancoil.brd, fancoil.sch, fresh_air_control.brd, fresh_air_control.sch]
2025-07-16 switch modbus TXD pin and add some logging
2025-07-16 Fix inverted fancoil O/B
    [OutCtrl.cpp]
2025-07-17 correct comments on timers in fresh_air_control
    [main.cpp]
2025-07-17 enable overflow interrupt
2025-07-18 Apply fixed offset to controller temp sensor
    [ControllerApp.cpp]
2025-07-18 Fix display of outdoor temp and allow older temps
    [ControllerApp.cpp, ControllerDomain.h]
2025-07-19 Fix tests for switch to weather API
    [ControllerApp.cpp, ControllerApp.h, controller_main.cpp]
2025-07-19 Fix precooling messaging and make precooling more aggressive
    [ControllerApp.cpp]
2025-07-22 Only measure static pressure if fan was turned on recently
2025-07-22 Log on fan/hvac state changes
2025-07-24 Rewrite zone_io to reduce sensitivity to electrical noise
    [main.c]
2025-07-24 Working new zone_io and fix some tests
    [main.c]
2025-07-24 Do not turn zone pump on until at least one valve is open
2025-09-30 Make pressure formatting portable
2025-09-30 Switch to https for homeassistant
2025-09-30 Send temperature correction to SCD40
    [AbstractSensors.h, ControllerApp.cpp, Sensors.cpp, co2_client.cpp]
2025-10-01 Revert "Send temperature correction to SCD40"
    This didn't work correctly since it would require
    stopping periodic measurement for each correction.
    Also I'm pretty sure the humidity sensor is just far
    too inaccurate for this to be worth messing with.
    This reverts commit e02ef607daec0f92fb8c7cdc6faf570490be1290.
    [AbstractSensors.h, ControllerApp.cpp, Sensors.cpp, co2_client.cpp]
2025-10-17 Revert "adjust temp offset a bit"
    Pretty sure this was overcompensating for slow response
    rather than actual sensor offset. Response time is
    really only fixable with hardware/enclosure changes.
    This reverts commit 6f3a6acd5b04a7b8f2e5debeeaf8883b772fe4b2.
    [controller_main.cpp]
2025-10-27 temperature sensor board for controllers
    [temp_board.brd, temp_board.sch]
2025-10-29 Don't mess with heat pump in test mode
2025-10-29 save temp_board as printed
    [20251027-temp_board.brd, 20251027-temp_board.sch]
2025-10-30 Add support for clearing messages and delay turning off zone pump on CX errors
    [ZCDomain.cpp, zc_main.cpp]
2025-10-30 Implement tests for new behavior in heat pump errors
    [FakeModbusClient.h]
2025-10-31 Really fix logging this time
    [ZCDomain.cpp]
2025-10-31 Rate limit state change on valves/pumps
2025-11-10 Make STS sensor i2c address a parameter
2025-11-10 Read and log off-board temp sensor
2025-11-10 Formatting and compilation fixes
    [ControllerApp.cpp, ControllerDomain.h, Sensors.cpp]
2025-11-10 Reference tempC when checking if sensors are ready
2025-11-10 off-board temp pcb tester
2025-11-11 Fix minor bugs in offboard sensor
    [ControllerApp.cpp, Sensors.cpp]
2025-11-11 Use off-board temp sensors
2025-11-11 Fix AC without outdoor temp reading
    [ControllerApp.cpp]
2025-11-11 Calibrate off-board temp sensors
2025-11-12 Fix bug in fan override message
    [ControllerApp.cpp]
2025-11-12 Fix bug in sensor init
    [Sensors.cpp]
2025-11-12 Add outputActive to PID instead of integral deadband
2025-11-15 Allow longer and indefinite fan speed overrides
2025-11-18 Adjust sensor offset a bit
2025-11-18 Implement load control for powerwall
2025-11-20 Avoid error message with no fancoil
    [AbstractModbusController.h, ModbusController.cpp]
2025-11-29 Switch to MqttHomeClient and rm http-based HASSClient
2025-11-29 switch topics
2025-12-02 enable load shedding from powerwall
2025-12-10 WIP continuous fan UI, config, config migrations
2025-12-10 Continuous fan option
2025-12-12 log co2 calibration state
2025-12-27 fix pin inversion for exhaust ctrl
    [main.cpp]
2025-12-27 fix exhaust ctrl timing
    [ControllerApp.cpp, ControllerApp.h]
2026-02-28 Tweak fan cooling parameters
2026-02-28 Implement fan min on time
2026-03-19 poll heat pump current and ambient temp
2026-03-19 shorten OTA check intervals
    [controller_main.cpp, zc_main.cpp]
2026-03-19 Remove CO2 calibration arbitrary ppm threshold
2026-06-07 Update CO2 calibration test expectations for new baseline PPM
    BASELINE_PPM was bumped from 421 to 435 in 6d7685d but the test
    expected values weren't updated.
2026-06-07 Migrate to esp_netif_sntp API, remove deprecated includes
    - Replace esp_sntp_setoperatingmode/setservername/init/stop with
    esp_netif_sntp_init/deinit (new API available since IDF 5.1)
    - Add ESPWifi::setSNTPCallback() to thread the time-sync callback
    through to the SNTP config struct instead of the legacy setter
    - Remove dead #include "esp_freertos_hooks.h" from controller_main.cpp
    - Fix portTICK_RATE_MS -> portTICK_PERIOD_MS in zone_io_tester
    - Gitignore .claude/settings.local.json (personal/machine-specific)
    [controller_main.cpp, main.cpp]
2026-06-07 Fix IDF 5.5.1 compatibility: uint and Kconfig syntax
    - Replace bare 'uint' with 'unsigned int' in cxi_client — GCC 14
    no longer provides 'uint' as an implicit POSIX typedef
    - Fix i2c_manager Kconfig 'def_bool y' syntax — the newer kconfgen
    parser bundled with IDF 5.5 rejects the shorthand form; use
    'bool / default y' instead
    - Update dependencies.lock for IDF 5.5.1
2026-06-08 Migrate display from lvgl_esp32_drivers to esp_lcd
    Replace the forked lvgl_esp32_drivers display path (custom disp_spi +
    ili9341.c) with esp-idf's esp_lcd plus the espressif/esp_lcd_ili9341
    managed component. The LVGL glue and threading model are unchanged: the
    app still owns the lv_disp_drv flush callback, the mutex_/handleTasks
    loop, and LV_TICK_CUSTOM. esp_lcd drives the panel over SPI and signals
    flush completion via on_color_trans_done.
    init_display moves from a header-only definition to a compiled
    ui_common/src/init_display.c. Orientation is reproduced from the
    previous MADCTL behaviour: both builds are landscape (swap_xy), and the
    zone_controller is additionally mirrored (LANDSCAPE_I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
    [init_display.c, init_display.h]
2026-06-08 Migrate I2C from i2c_manager to the esp_lcd_touch + i2c_master driver
    The legacy I2C driver (driver/i2c.h) aborts at boot if the new i2c_master
    driver is also linked, so the touch panel and all I2C sensors had to move
    to the new driver together.
    New shared i2c_bus component wraps i2c_master: one bus on I2C_NUM_0 with a
    small per-address device-handle cache, exposing i2c_bus_read/write with the
    same reg/NO_REG encoding the old i2c_manager used so call sites port
    directly. The bus handle is shared with the touch panel; the driver
    serializes access, so the old lvgl_i2c_locking shim is gone.
    - Sensor/RTC HALs (scd40, embedded-sts, rtc-rx8111) now use i2c_bus.
    - Touch (FT6X36) moves to esp_lcd_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
2026-06-08 Remove the lvgl_esp32_drivers fork
    PR1/PR2 moved the display and touch onto esp_lcd/esp_lcd_touch, leaving
    the fork in the tree only for the display-pin/orientation Kconfig and the
    esp_lcd_backlight helper. Replace both and drop the fork.
    - Display wiring + orientation now come from a display_config_t the app
    shims pass to init_display(), the same way the I2C pins moved to
    i2c_bus_init(). No more CONFIG_LV_DISP_*/ORIENTATION dependence; the
    panel mirror and touch transform key off cfg.landscape_inverted at
    runtime instead of compile-time #ifdefs.
    - Add a small LEDC-PWM backlight (ui_common/backlight.c) replacing
    esp_lcd_backlight; SleepManager keeps the same disp_backlight_* API.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
    [SleepManager.h, app_main.c, backlight.c, backlight.h, init_display.c, init_display.h, main.c]
2026-06-11 Report static pressure to Home Assistant
2026-06-17 Treat temp as unreliable while sensor warms up after boot
    On a cold boot the indoor temperature sensor self-heats and its readings
    aren't accurate for ~15m. During that window we now treat the temperature
    as unreliable: the UI shows "--", the heating algorithm is skipped (cooling
    still runs since we'll just under-cool while the sensor warms), and a
    cancellable "No heat while temp stabilizes" message is shown. Cancelling the
    message fully cancels the warmup (sensor treated as warm).
    A clean software restart (ESP_RST_SW, e.g. OTA or intentional reboot) skips
    the warmup since the sensor is already warm; a power-on or crash does not.
    Also hold off enabling A/C purely because the outdoor temp i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
    [ControllerApp.cpp, ControllerApp.h, controller_main.cpp]
2026-07-22 Don't forward esp-modbus errors to syslog
    esp-modbus logs an error for every failed transaction with no context
    beyond the esp_err_t, and callers retry, so they arrive several to a
    failure and duplicate the caller's own logging.
    Filter by tag in the remote logger rather than with esp_log_level_set()
    so they still print over UART and stay visible when debugging over USB.
2026-07-22 Remove hot-day precooling, lower A/C outdoor temp threshold
    Precooling straight to the next schedule's setpoint when the outdoor
    temp was well above the current one had no hysteresis, so the setpoint
    could swing by the full gap between schedules as the outdoor temp
    crossed the threshold. Precooling is now purely the time-based ramp.
    The A/C is better sized for the spaces now, so getting this far ahead of
    the heat is less necessary. Drop AC_ON_OUT_TEMP_THRESHOLD_C to 4F to
    bring the A/C on a bit sooner to compensate.
    Removes PrecoolingOnHotDay, which only covered the deleted branch.
2026-09-10 Fix zone controller sensor IDs in HA
2026-09-10 sensor naming
2026-09-10 Don't publish sentinel values for failed heat pump reads
    logSystemState seeded hpOutT/hpACCurrent/hpAmbientT to -1, hpHz to
    UINT16_MAX and cxOpMode to Unknown, then called the Modbus getters
    without checking their esp_err_t. The getters only write through their
    out-param on ESP_OK, so any failed read left the sentinel in place and
    published it to Home Assistant as a real reading. -1.0 is a plausible
    ambient temperature, so this wasn't distinguishable downstream.
    Readings now travel as a HeatPumpState of optionals, populated only when
    the read succeeds. MqttZCHomeClient merges each field into its last
    known good value, so a failed read is not a change, publishes nothing,
    and leaves the retai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
2026-09-10 Track Home Assistant sensor updates per sensor
    Publishing was flagged by a single State bit, so any one value changing
    republished all eight topics. That reset Home Assistant's last-updated
    time across the board, hiding which individual values were actually
    fresh — including ones whose Modbus read had been failing for a while.
    Give each sensor its own flag, set only when that value changes, and
    publish and clear them independently, as MqttHomeClient does. A failed
    read still flags nothing, so its sensor stays untouched and visibly
    stale while the rest keep updating. On reconnect only sensors we hold a
    value for are re-flagged.
    Claude-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
2026-09-10 Clear heat pump values in the client when a read fails
    lastHp_ held the last successfully read value indefinitely, so a sensor
    whose Modbus read had been failing for hours would still be republished
    on reconnect, stamping a stale reading with a fresh time in Home
    Assistant.
    Record every reading, failed ones included, so lastHp_ reflects what we
    currently know. Publishing is still flagged only for readings we
    actually took, so a failed read publishes nothing and reconnect
    re-flags only sensors that are reading now. A reading that returns after
    a gap republishes even if the value is unchanged, which is right: it is
    a fresh measurement.
    Cl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
2026-09-21 Expose fan, numeric HVAC mode, and fancoil speed to Home Assistant
    Adds three components to the HA discovery payload:
    - A "Fresh Air Fan" fan entity publishing on/off plus the raw 0-255
    FanSpeed, scaled by HA via speed_range 1-255 so no precision is lost
    to a percentage conversion. It is read-only for now: HA requires a
    command_topic on an mqtt fan, so the command topics are advertised
    but not subscribed, and `optimistic: false` makes HA revert its
    controls rather than show a state we never entered.
    - "HVAC Mode" as a numeric sensor (0=off, 1=heat, 2=cool), mirroring
    the existing string action topic for metrics backends that don't
    handle string states well.
    - "Fancoil Speed" a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
2026-09-21 Use PBR fancoil cutoffs in controller tests
    The fancoil tests assert on specific speed transitions, but 0c28c1b
    ("tweak thresholds for new fancoils") reduced the default heat curve to
    Off/Min/Low/Med, dropping High. Heating could no longer reach High at
    any demand, so CallsForFancoilHVAC, IncreasesFancoilSpeedOverTime and
    AllowHVACChangeLimit had been failing since that commit, which changed
    only ControllerApp.h and left the tests untouched.
    Point the test config's logName at "_pbr" so getSpeedForDemand picks the
    PBR cutoffs, which still carry a full Min/Low/Med/High curve for both
    modes and keep every transition under test observable.
    PBR puts Low at 0.35 rather than 0.5, so two input tem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
2026-09-21 Run unit tests before releasing
    Three controller tests had been failing since 0c28c1b without blocking
    anything, because nothing between editing code and shipping firmware ran
    them. Gate the release on test/run_tests.sh so that can't happen again.
    Placed after the dirty checks, which are cheaper and fail faster, and
    before idf.py build and any ssh/scp, so a failing suite costs nothing and
    can't reach the OTA host. Both projects release.sh can run in (controller
    and zone_controller, the two with an sdkconfig) have a test/run_tests.sh
    and currently pass; a project without one warns rather than failing.
    Claude-Session: https://claude.ai/co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
2026-09-22 Expose the thermostat schedule to Home Assistant
    Home Assistant can now read and write the day/night schedule over MQTT.
    The schedule is published as retained JSON on home/<name>/schedule/state
    and accepts full or partial updates on home/<name>/schedule/cmd, e.g.
    {"night":{"cool_f":76}}. Discovery adds six config entities (heat/cool
    setpoint numbers and start time texts for day and night) that read from
    the state topic and send single-field updates.
    The UI's SetSchedule event is replaced by UpdateSchedule, which both the
    UI and MQTT use, so the controller is the single place schedules are
    validated: temps are rounded to whole °F and clamped to the temp limits,
    the other setpoint is pushed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
2026-09-23 Replace FreeRTOS mutexes with std::mutex
    Use std::lock_guard for all C++ mutex usage in the shared components,
    controller and zone controller. Locked regions are unchanged; regions
    that previously released before blocking calls use block scopes.
    UIManager::sendEvent no longer releases and re-takes the UI mutex
    around the event callback. The deadlock this worked around was the
    re-entrant setSystemPower call, fixed alongside it in c3058f1. The UI now
    uses a non-blocking callback so a full event queue can't stall the UI
    task while it holds the lock.
2026-09-23 Keep the heat setpoint below the precooling setpoint
    Precooling lowers the cool setpoint toward the next schedule's, which can
    push it below the current schedule's heat setpoint. Lower the heat setpoint
    as needed to maintain MIN_HEAT_COOL_DELTA.
2026-10-06 Satisfy cooling demand from the fan before the A/C
    Since the A/C now stays enabled for an hour after it last cooled, it was
    coming on for small excursions above the setpoint that the fan could have
    handled. The fan and A/C ran off independent PIDs, so the A/C started at 0.6F
    over the setpoint while the fan was only at ~20%.
    Use a single cooling demand instead, where a demand of 1 means 3000 BTU/hr:
    - The fan delivers about 150 BTU/hr per degree F that the outdoor temp is
    below the indoor temp. It runs at the speed that delivers the demand, still
    limited at small indoor/outdoor deltas.
    - The fancoil is only asked for the demand the fan isn't delivering. Valve
    cooling still uses its ow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
2026-10-06 Have valve cooling take the remaining cooling demand too
    Valve cooling kept its own on/off algorithm while fancoils took whatever
    cooling demand the fan didn't cover. We don't use valve cooling right now, so
    drop the separate path: valves turn on whenever there is any remaining demand.
    With no cooling equipment there is no A/C demand, which the null cooling
    algorithm used to take care of.
    Claude-Session: https://claude.ai/code/session_01RnnS9fRg1oojg6eBvEFthm
2026-10-06 Explain why fan cooling capacity isn't capped at 1
    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
2026-10-06 Simplify the fan speed over time test to a single time step
    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
2026-10-06 Tighten the fan speed bounds in the precooling test
    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
2026-10-06 Don't wind up cooling demand when the fan is at its limit
    The cooling PID integrated whenever the fan was delivering any cooling. With
    the fan at its limit and the A/C not enabled, more demand can't deliver more
    cooling, so the integral just built up. That kept the fan running below the
    setpoint and meant the A/C started with demand already banked.
    Only count the fan as an active output when more cooling is available: the fan
    is below its limit, or the A/C is enabled to take the rest.
    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
2026-10-06 Make it clearer that demand above the fan's capacity counts as at its limit
    Also test that case rather than the fan being limited by a small
    indoor/outdoor delta.
    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
2026-10-06 Drop repeated test comments about the fan covering cooling demand
    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
2026-10-06 Enable the A/C when the coil is cold shortly after boot
    A cold coil could turn the A/C on at any time, but only with enough cooling
    demand. A restart loses the built up demand, and the fan now covers part of
    what's left, so after restarting with the A/C running we often wouldn't reach
    the threshold before the coil warmed up.
    Treat a cold coil in the first few minutes after boot as evidence that the A/C
    was running and enable it whatever the demand. It still only runs once there
    is enough demand for the fancoil.
    Outside of that window a cold coil no longer turns the A/C on. It mostly
    means we just put the A/C in standby, e.g. because it got cold outside.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
2026-10-06 Widen the cooling demand range to 4F
    With a 2F range the fan went to nearly full speed for small excursions above
    the cooling setpoint, since it takes a lot of air to deliver the demanded
    cooling. Doubling the range roughly halves the fan speed at a given
    temperature, which is closer to how fan cooling used to behave.
    This also means the A/C needs to be twice as far above the setpoint to turn on
    or reach a given speed before the integral builds up.
    Tests use temperatures further above the setpoint to get the same demands.
    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
2026-10-10 Don't turn the A/C off when it gets cold outside
    The A/C went to standby when the outdoor temp fell 10F below the cooling
    setpoint. The fan now covers more of the cooling demand the colder it is
    outside, so at that point the A/C only runs if the fan is at full speed and
    still can't keep up, which is when we'd want it.
    This also keeps a forced A/C override or a cold coil at boot from being undone
    right away when it's cold outside.
    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
2026-10-11 Debounce fancoil inputs for 15 seconds
    Fancoil 2 raises V about two seconds before OB when it starts a heat
    call. The zone controller read that as a cool call, switched the heat
    pump to cool and then locked out the heat for the rest of the call.
2026-10-12 Correct a retained "unavailable" while connected
    After a reboot the broker can publish the last will of the previous
    connection after the new connection's "1", leaving the device marked
    unavailable in Home Assistant until its next reconnect. Subscribe to our
    own availability topic and republish "1" when it says anything else.
2026-10-17 Keep the PID integral while the setpoint ramps
    Precooling lowers the cool setpoint a little every minute, and any setpoint
    change reset the integral, leaving only proportional demand. Now the integral
    only resets on steps of at least 0.25F or on moves that reduce demand.
2026-10-17 Clarify when the PID integral resets
2026-10-17 Never reset the PID integral when demand increases
    A setpoint move that increases demand, however large, still needs at least
    the output we were already giving, so only reset on moves that reduce demand.
2026-10-18 Report the HVAC state from what's actually running
    The state was derived from demand, so with the A/C on and cooling demand
    too low to run the fancoil, the UI showed a cooling outline (and Home
    Assistant reported "cooling") with the fancoil off. Derive it from the
    speed actually commanded instead, which also covers changes delayed by
    allowHVACChange. Valve systems now record Off when the valve closes.
2026-10-18 Don't restart the HVAC change timer while staying on
    Once MIN_HVAC_ON_INTERVAL had elapsed, staying on in the same mode hit
    the interval branch and reset hvacLastTurnedOn_, so turning off or
    switching modes could be delayed by up to twice the interval. Check for
    the same mode first so the timer only moves on a real change.
2026-10-24 Move components/wifi to the metcalf/esp-iot-core submodule
    The Wi-Fi/OTA/MQTT base is now shared with shop-exhaust-control and the
    upcoming dust collector controller. History was carried over with
    git filter-repo. Mounted at components/esp-iot-core, so the IDF component
    is now esp-iot-core and consumers REQUIRE that. The local
    wifi_credentials.h and remote_spec.cfg stay gitignored inside the submodule.
