metcalf/hvac_control/(notices)

Notices in the files:
parts and their libraries:
SparkFun-Capacitors: Licensing: Creative Commons ShareAlike 4.0 International - https://creativecommons.org/licenses/by-sa/4.0
COPYRIGHT: Copyright (C) 2023 Ultra Librarian. All rights reserved.
COPYRIGHT: Copyright (C) 2024 Ultra Librarian. All rights reserved.
